Deimos48/Braille_Public/Скриншоты 3D моделей/Основание (2).png

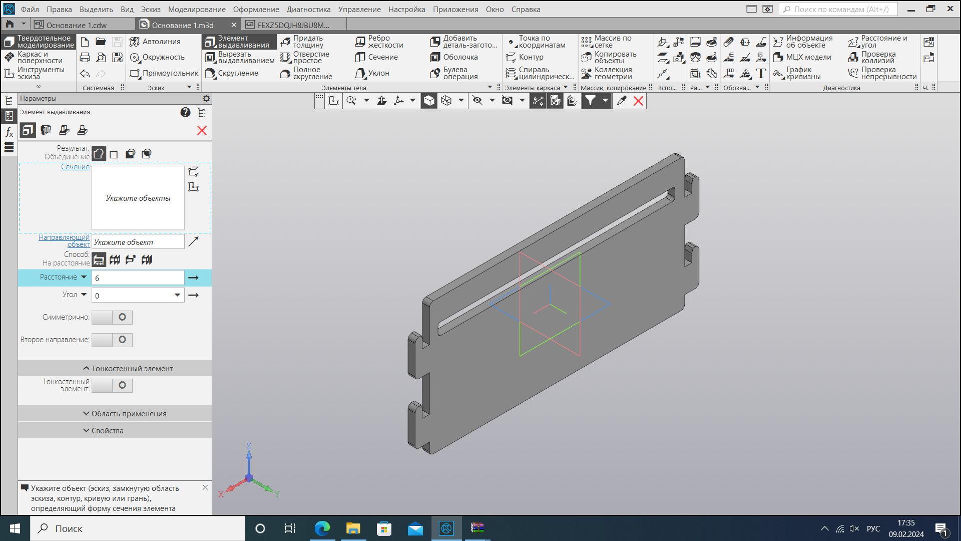
Скриншоты 3D моделей/Основание (2).png
