Deimos48/Braille_Public/Документация для предпрофиля.pdf

Московская предпрофессиональная олимпиада (https://predprof.olimpiada.ru/)

Инженерно-конструкторское направление. Инженерно-конструкторский профиль

ДЕПАРТАМЕНТ ОБРАЗОВАНИЯ И НАУКИ ГОРОДА МОСКВЫ

Государственное бюджетное общеобразовательное учреждение

города Москвы «Школа № 1103 имени Героя Российской Федерации

А.В. Соломатина»

Продуктовый сектор. Профиль «Инженерия»

Пояснительная записка к кейсу №1

Принтер Брайля с голосовым управлением

Выполнили:

ученики 11Б класса ГБОУ Школы № 1103

Ларкин Григорий Максимович,

Григорьев Андрей Андреевич,

Приоров Артемий Сергеевич,

Рахманин Максим Олегович,

Донцов Илья Игоревич

Руководитель:

Сокур М.Е., учитель информатики

Москва, 2024

Оглавление

4. Описание используемых аппаратных и программных узлов, модулей,
5. Функциональное описание разработанного решение в виде UML-
9. Алгоритм работы разработанного программного обеспечения в виде
12. Видеоролик, демонстрирующий функционирование разработанного

### 1. Цель и задачи работы

1.1. | Цель работы – | Разработать и изготовить принтер Брайля (далее

программно-аппаратный комплекс или ПАК) с расширенным функционалом,

в том числе с голосовым управлением, для быстрого создания печатных

заметок для людей с ограничениями по зрению.

1.2. Задачи работы:

− Разработать и создать корпус ПАК;

− Разработать и создать кинематическую схему печати символов;

− Разработать и создать электротехническую систему устройства;

− Выбор микроконтроллера для разработанной системы;

− Разработать систему голосового управления для распознавания

| текста и команд;

− Разработать алгоритмы и ПО для разработанной архитектуры ПАК.

### 2. Описание команды

Членами нашей команды являются Григорьев Андрей, Донцов Илья,

Ларкин Григорий, Приоров Артемий, Рахманин Максим. Распределение ролей

представлено в Таблица 1.

Таблица 1. Распределение ролей в команде

Фамилия, имя члена команды | Задача ученика в команде
Григорьев Андрей | Сборка ПАК, исправление возникших проблем
Донцов Илья | Создание программного кода
Ларкин Григорий | Сборка ПАК, поиск требуемых компонентов и материалов
Приоров Артемий | Создание 3D-моделей ПАК, чертежей, кинематических схем
Рахманин Максим | Разработка документации, создание UML-схем

### 3. Описание функций разработанного решения

3.1. Управление принтера производится с помощью голосовых команд,

произносимых пользователем. Например, команда «Абзац» делает

перенос на новую строку.

3.2. Когда пользователь произносит команду «Запись», встроенный

микрофон начинает распознавать и записывать слова в течении 5

секунд. При необходимости максимальное время записи можно

программно изменить.

3.3. Записанная на микрофон речь передаётся микрокомпьютером

Raspberry Pi 3 в сервис Yandex Cloud, где происходит её

распознавание. | Текстовое | содержимое | сохраняется | на

микрокомпьютере.

3.4. Как только речь была записана, Raspberry Pi 3 передаёт её на

микроконтроллер Arduino. Там речь переводится в текст Брайля и

подаётся на печать.

3.5. Печать происходит построчно. Печатная головка двигается по

горизонтали с помощью шагового мотора. Прокрутка бумаги по

вертикали реализована вторым шаговым мотором и системой

прижимных роликов.

4. Описание используемых аппаратных и программных узлов,

модулей, фреймворков и других инструментов

Список основных компонентов, используемых для создания данного

проекта, представлен в Таблица 2.

Таблица 2. Используемые компоненты и ПО

Название компонента и его назначение в проекте | Внешний вид

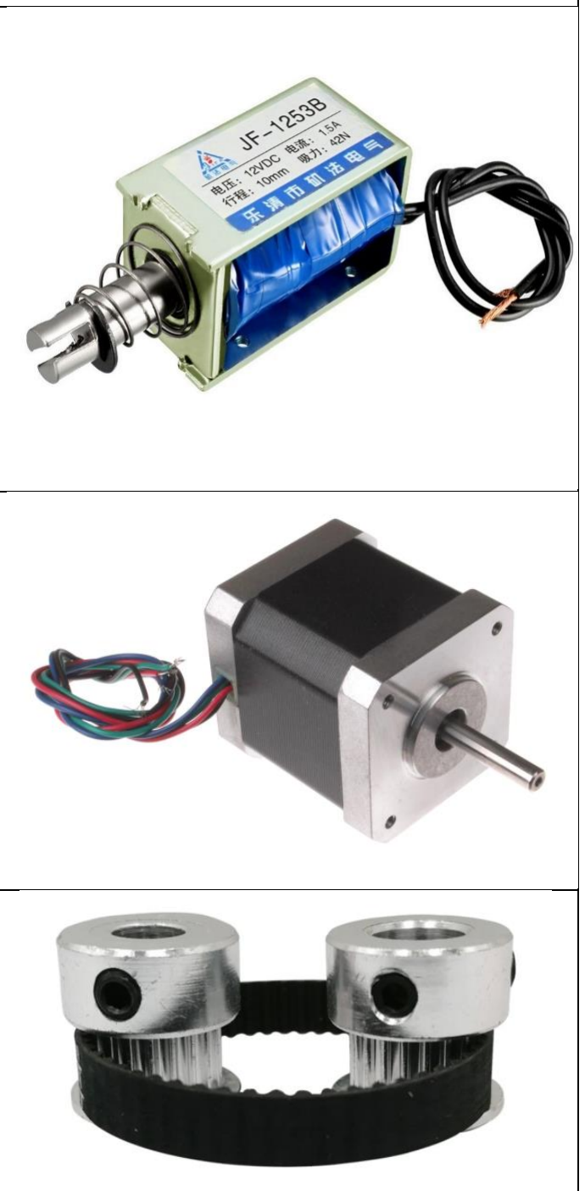
[picture p3: figure]

Соленоид JF-1253B В данном проекте он используется для печати на бумаге рельефно-точечным шрифтом Луи Брайля.

Шаговый мотор Nema17 Предназначены для перемещения печатной головки по горизонтальной плоскости, листа бумаги по вертикальной плоскости

Шкив GT2-20 С помощью ременной передачи вращение с шаговых двигателей передаётся на ремень, который приводит в движение печата ющую головку принтера

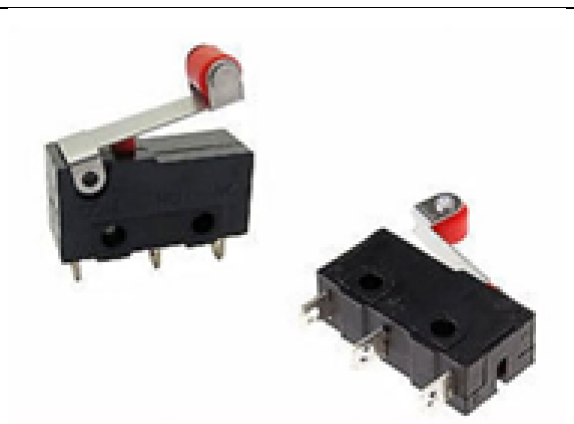
[picture p4: figure]

Концевой переключатель Подаёт на плату Arduino сигнал, когда печатная головка дошла до крайнего положения листа. После получения этого сигнала продвигается бумажный лист, чтобы продолжить печать на новой строке.

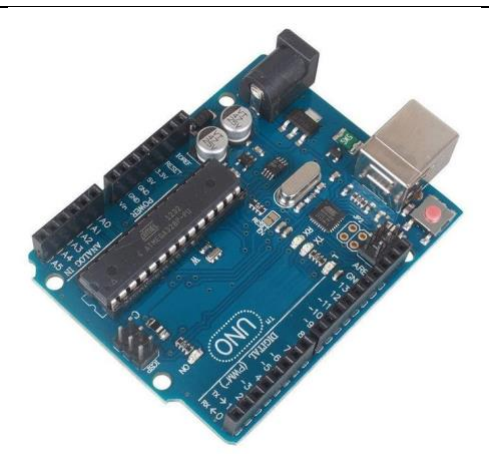
[picture p5: figure]

Arduino Uno Микроконтроллер, отвечающий за управление шаговыми моторами и печатью. Весь программный код писался в интегрированной среде разработки Arduino IDE, использующий C-подобный язык программирования.

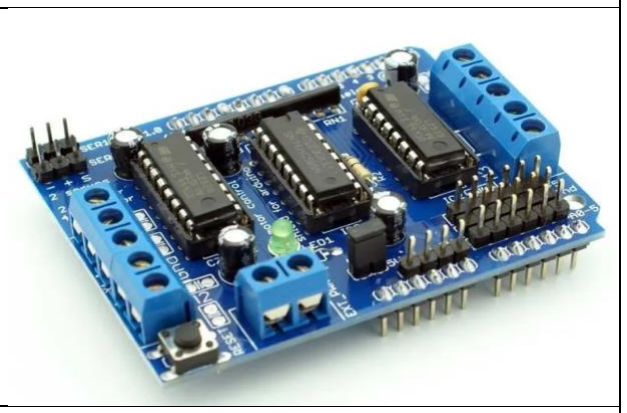
[picture p6: figure]

Motor Shield Плата расширения, предназначенная для управления скоростью и направлению вращения шаговых моторов постоянного тока.

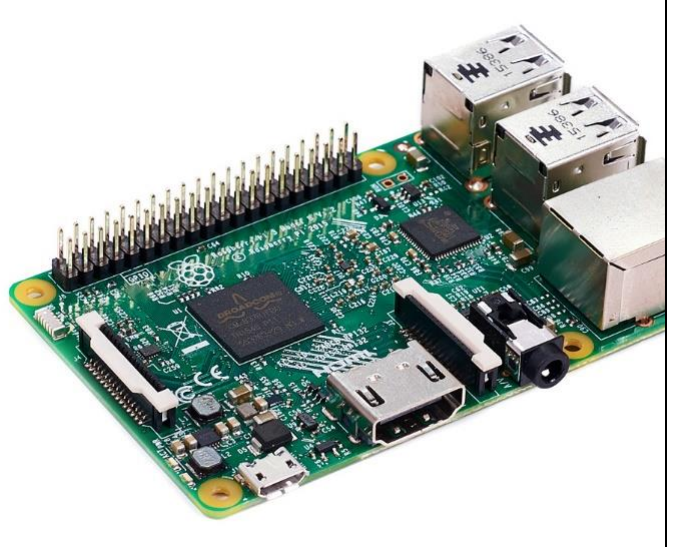
[picture p7: figure]

Raspberry Pi 3 Микрокомпьютер, на котором, за счёт облачных сервисов, реализовано распознавание речи. В данном проекте используются следующие модули: time, requests, RPi.GPIO, soundfile, pyaudio, wave, serial

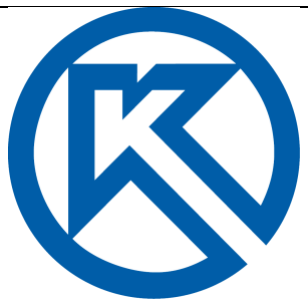
[picture p8: figure]

САПР «Компас-3D» Средство автоматического проектирования, в котором создавались 3D модели деталей, чертежи, кинематические схемы

Arduino IDE Интегрированная среда программирования. Предназначена для разработки и загрузки программного кода на Arduino-совместимые платы. В данном проекте используются следующие библиотеки: AFMotor, TMRpcm

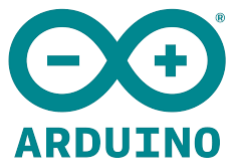
[picture p9: figure]

### 5. Функциональное описание разработанного решение в виде

UML-диаграмм

### 5.1. Диаграмма вариантов пользовательского взаимодействия с

системой

Произнеся команду «Запись», пользователь может говорить в микрофон

текст для печати, а также команды для принтера, управляя его работой. Также

пользователь может класть и доставать бумагу для печати. В необходимый

момент, пользователь может нажать на кнопку Reset, тем самым остановить

печать.

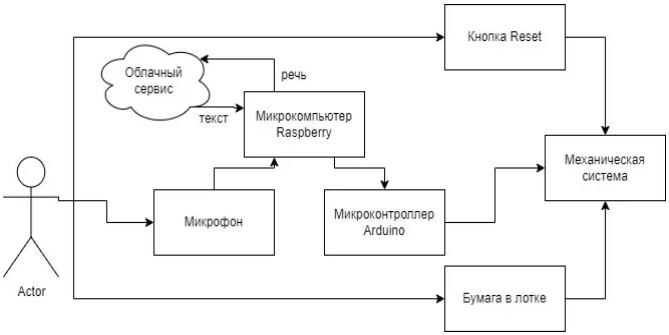
[picture p10: figure]

Рисунок 1. Диаграмма вариантов пользовательского взаимодействия с системой

### 5.2. Диаграмма автомата

У принтера есть 2 основных состояния: выключенное и включённое. Во

втором состоянии он выполняет свои основные функции: после включения он

ждёт голосовой команды «Запись» для начала работы, после чего записывает

речь пользователя. Записанный аудиофайл сохраняется на микрокомпьютер

Raspberry Pi 3, который отправляет его на облачный сервис Yandex Cloud, где

происходит распознавание речи. Получившийся в результате работы

облачного сервиса текстовый файл с распознанной речью отправляется

обратно на Raspberry Pi 3. Далее текст отправляется на микроконтроллер

Arduino, где преобразуется в текст Брайля и отправляется на печать.

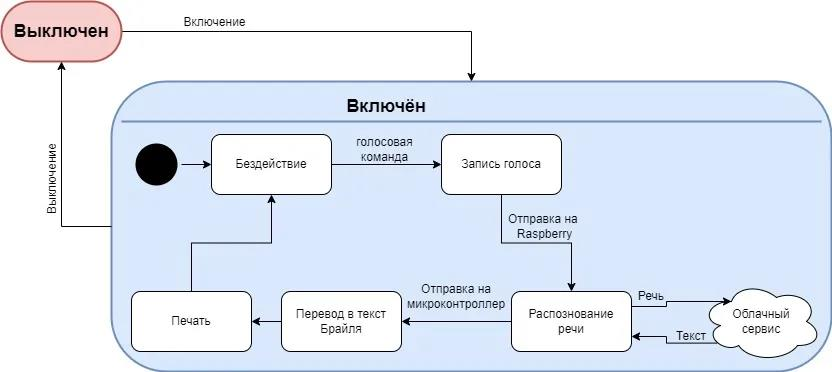
[picture p11: figure]

Рисунок 2. Диаграмма автомата

### 5.3. Диаграмма последовательности

После включения система ждёт, когда пользователь произнесёт команду

«Запись» для начала записи. После записи полученная речь отправляется

микрокомпьютером Raspberry Pi 3 для распознавания. С помощью облачного

сервиса Yandex Cloud реализовано распознавание речи. После обработки

микрокомпьютер передаёт полученный текст на микроконтроллер, где

происходит перевод в текст Брайля и совершается отправка на печать. При

обнаружении неполадки или иных непредвиденных ситуациях, пользователь

может нажать на кнопку Reset, чтобы совершить аварийную остановку.

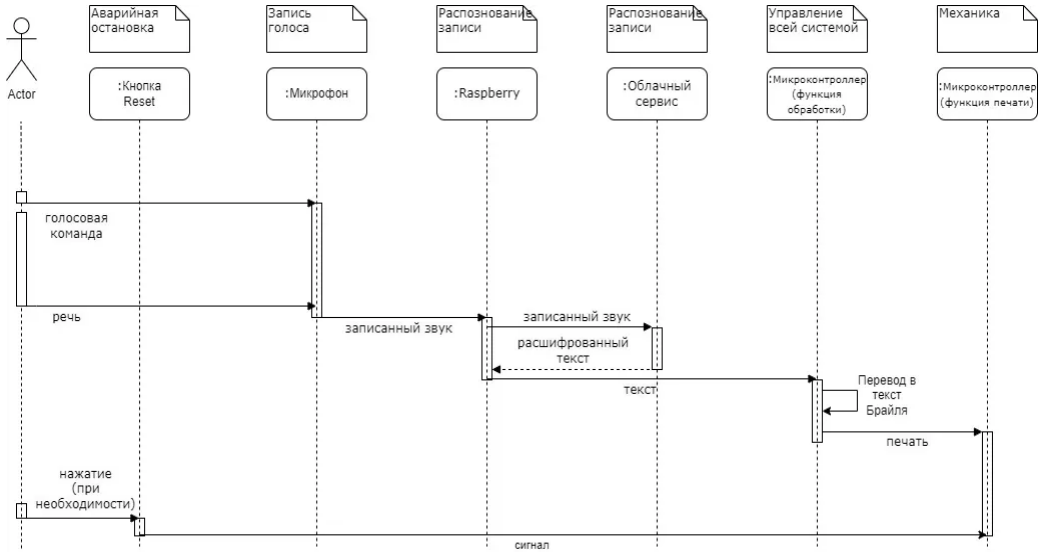
[picture p12: figure]

Рисунок 3. Диаграмма последовательности

### 5.4. Диаграмма компонентов

В нашем проекте используется один микроконтроллер, к которому

подключены все составляющие механизма печати. Также мы используем

микрокомпьютер Raspberry Pi 3 с подключенным к нему микрофоном для

распознавания речи. Специальная команда начала записи активирует

микрофон, а кнопка Reset напрямую взаимодействует с механизмом печати и

может остановить процесс при необходимости. Полученная при записи речь

сохраняется на микрокомпьютер Raspberry Pi 3, который отправляет её на

облачный сервис Yandex Cloud, где происходит распознавание речи.

Полученный таким образом текстовый файл обратно возвращается на

микрокомпьютер, который передаёт его микроконтроллер Arduino Uno, где

преобразуется по шрифту Брайля и отправляется на печать.

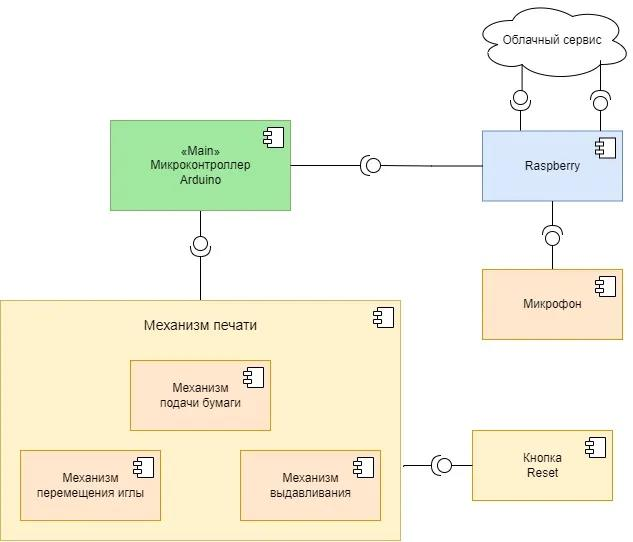
[picture p13: figure]

Рисунок 4. Диаграмма компонентов

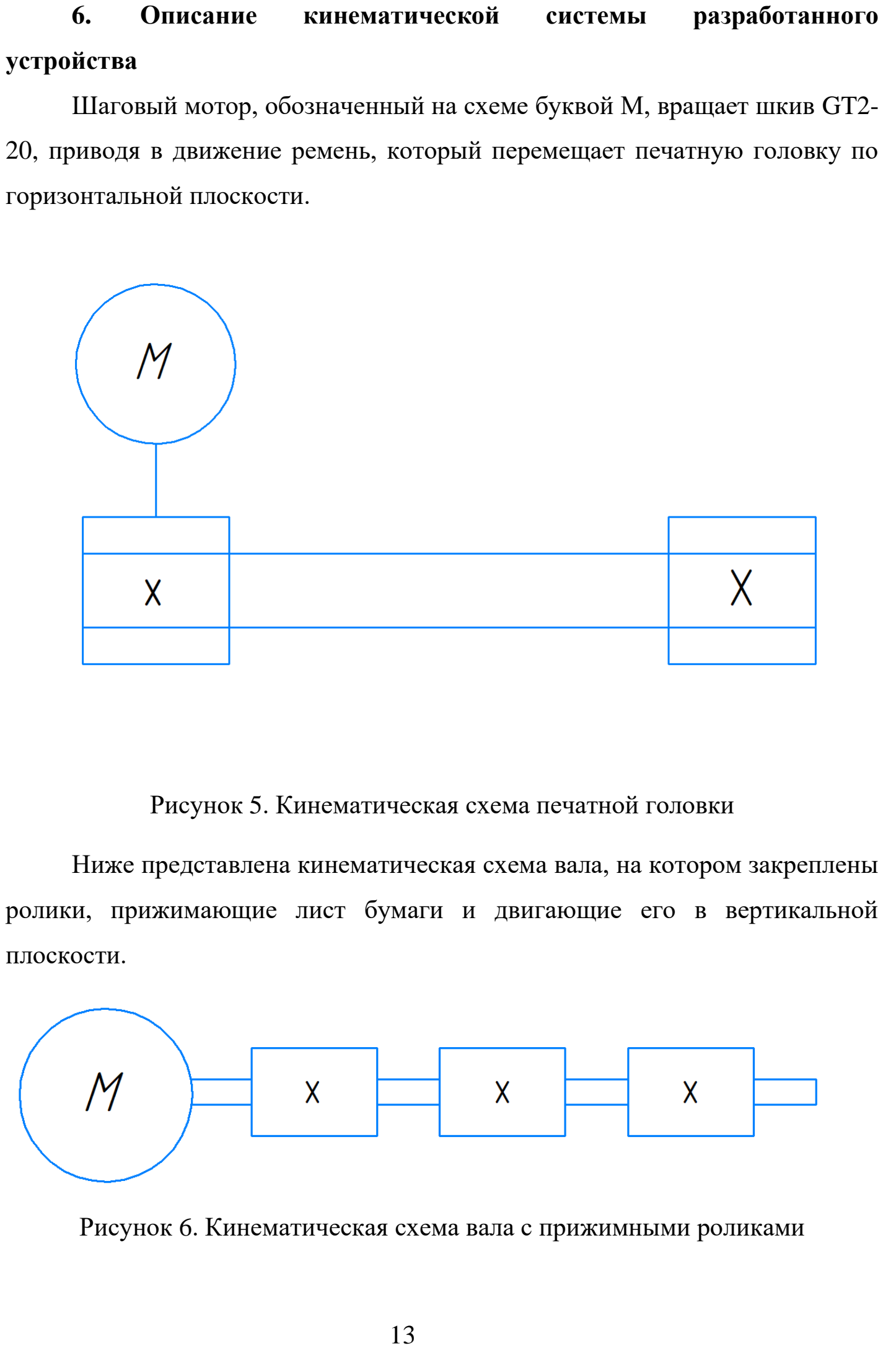
[picture p14: page 13]

6. | Описание | кинематической | системы | разработанного

устройства

Шаговый мотор, обозначенный на схеме буквой М, вращает шкив GT2-

20, приводя в движение ремень, который перемещает печатную головку по

горизонтальной плоскости.

Рисунок 5. Кинематическая схема печатной головки

Ниже представлена кинематическая схема вала, на котором закреплены

ролики, прижимающие лист бумаги и двигающие его в вертикальной

плоскости.

Рисунок 6. Кинематическая схема вала с прижимными роликами

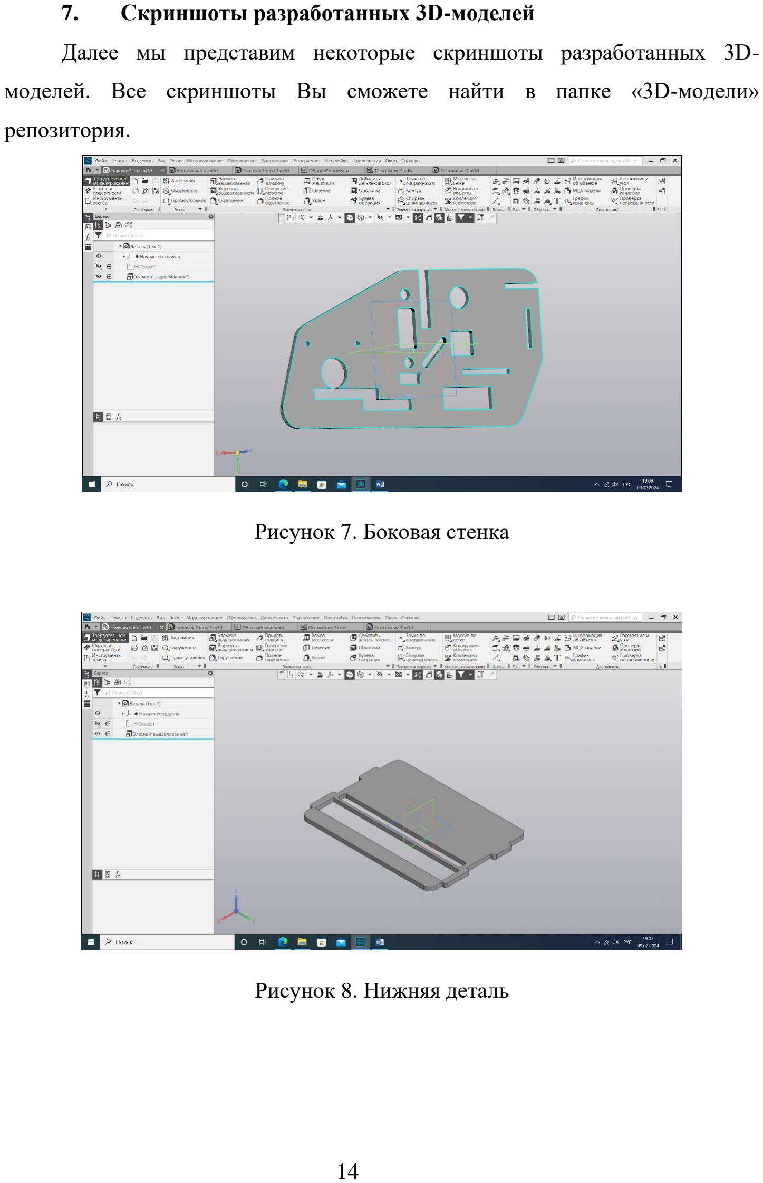
[picture p15: page 14]

### 7. Скриншоты разработанных 3D-моделей

Далее мы представим некоторые скриншоты разработанных 3D-

моделей. Все скриншоты Вы сможете найти в папке «3D-модели»

репозитория.

Рисунок 7. Боковая стенка

Рисунок 8. Нижняя деталь

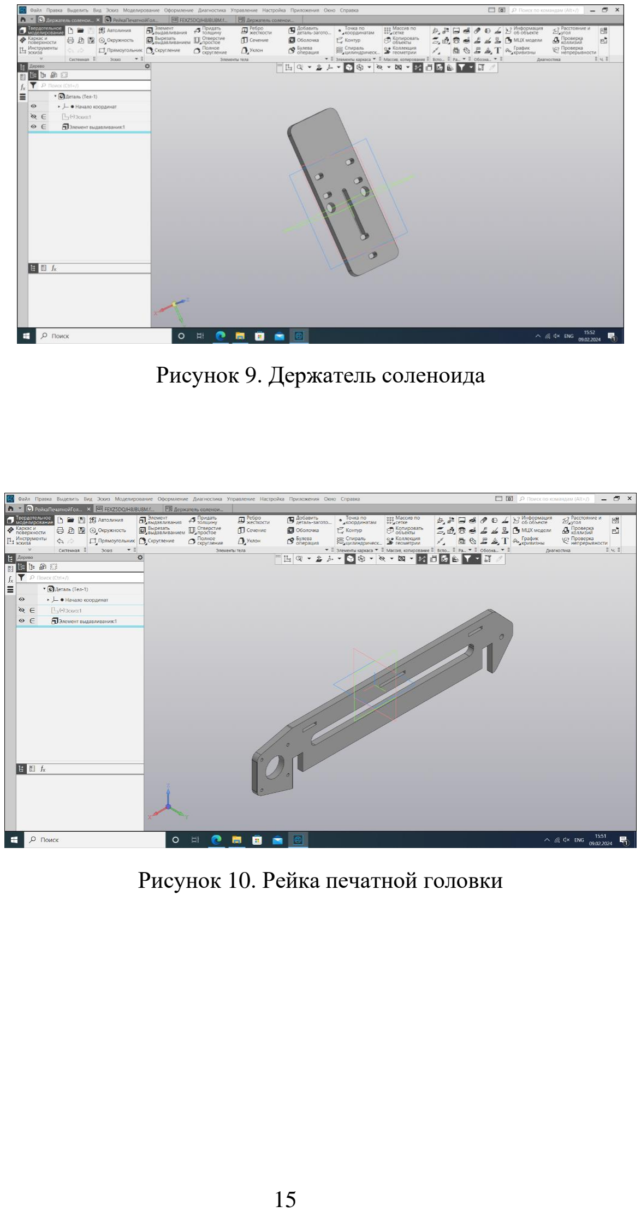
[picture p16: page 15]

Рисунок 9. Держатель соленоида

Рисунок 10. Рейка печатной головки

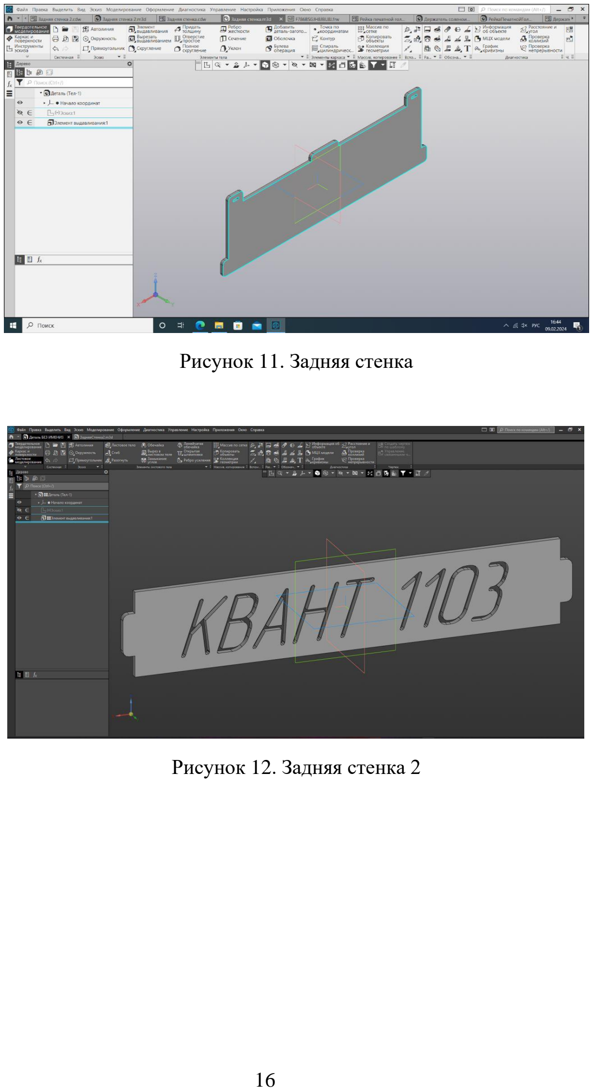
[picture p17: page 16]

Рисунок 11. Задняя стенка

Рисунок 12. Задняя стенка 2

8. | Описание | электротехнической | схемы | разработанного

устройств

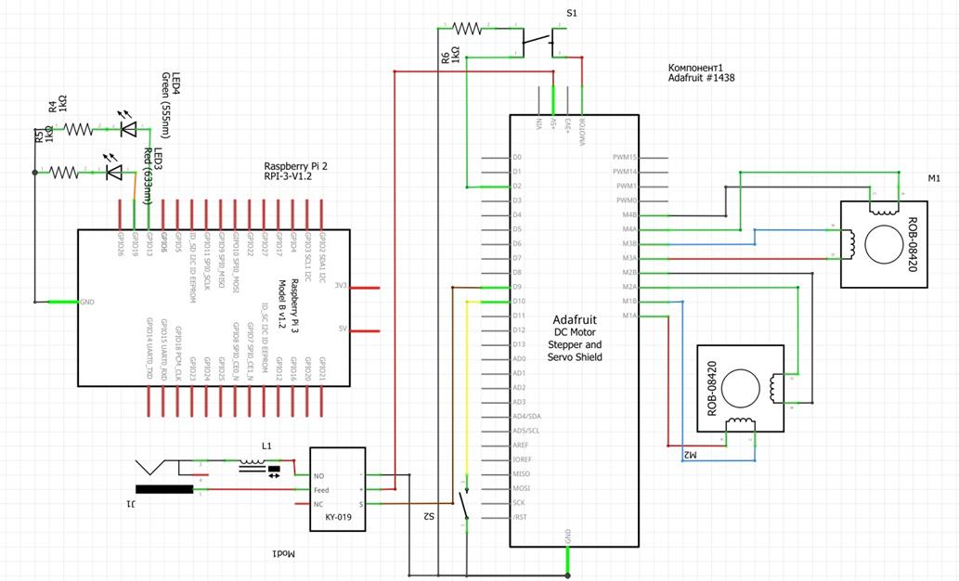
[picture p18: figure]

Рисунок 13. Принципиальная электрическая схема

К микроконтроллеру Arduino Uno подключена дополнительная плата

(Motor Shield) для управления шаговыми двигателями М1 и М2. К плате

подключен дополнительный источник питания +5В для питания двигателей.

Управление соленоидом осуществляется через порт D9, который управляет

промежуточным реле К1. Напряжение питания соленоида 12В. Концевой

выключатель подключен к порту D10. Кнопка аварийного останова

подключена к порту D2.

Связь | с | микрокомпьютером | Raspberry | осуществляется | по

последовательному интерфейсу. Используется внутренний преобразователь

USB-RS232, поэтому не требуется согласование уровней напряжения Arduino

(5 В) и Raspberry (3,3 В). На микрокомпьютере Raspberry для индикации

начала и завершения распознавания используются два светодиода. Для

ограничения тока светодиодов используются токоограничивающие резисторы

R4, R5 по 1 кОм.

### 9. Алгоритм работы разработанного программного обеспечения

в виде блок-схем

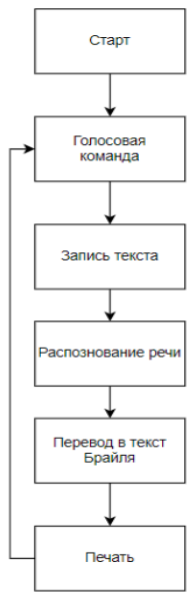
[picture p19: figure]

Рисунок 14. Общий алгоритм ПО

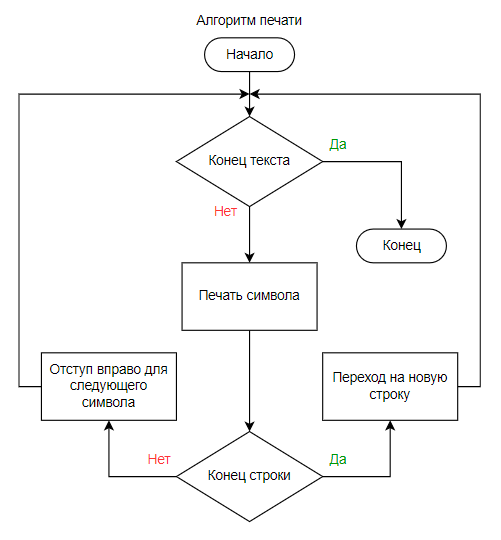
[picture p20: figure]

Рисунок 15. Алгоритм печати

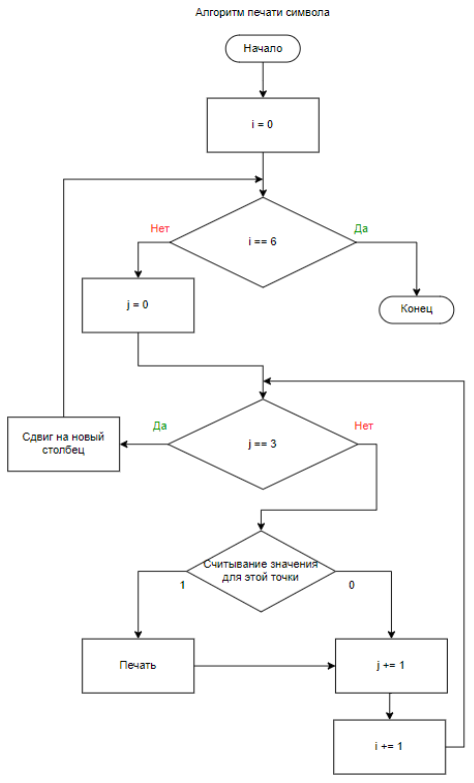
[picture p21: figure]

Рисунок 16. Алгоритм печати символа

10. Код разработанного программного обеспечения.

Код для работы нашего проекта Вы можете найти по этой ссылке:

- https://github.com/Deimos48/Braille_Public/tree/main/%D0%9F%D1

%80%D0%BE%D0%B3%D1%80%D0%B0%D0%BC%D0%BC%D

0%BD%D1%8B%D0%B9_%D0%BA%D0%BE%D0%B4/Python (https://github.com/Deimos48/Braille_Public/tree/main/%D0%9F%D1%80%D0%BE%D0%B3%D1%80%D0%B0%D0%BC%D0%BC%D0%BD%D1%8B%D0%B9_%D0%BA%D0%BE%D0%B4/Python)

- https://github.com/Deimos48/Braille_Public/tree/main/%D0%9F%D1

%80%D0%BE%D0%B3%D1%80%D0%B0%D0%BC%D0%BC%D

0%BD%D1%8B%D0%B9_%D0%BA%D0%BE%D0%B4/Arduino (https://github.com/Deimos48/Braille_Public/tree/main/%D0%9F%D1%80%D0%BE%D0%B3%D1%80%D0%B0%D0%BC%D0%BC%D0%BD%D1%8B%D0%B9_%D0%BA%D0%BE%D0%B4/Arduino)

### 11. Фотографии разработанного устройства и его составных

частей.

Фотографии разработанного устройства Вы можете найти по этой

ссылке:

- https://github.com/Deimos48/Braille_Public/tree/main/Фотографии_

разработанного_устройства (https://github.com/Deimos48/Braille_Public/tree/main/%D0%A4%D0%BE%D1%82%D0%BE%D0%B3%D1%80%D0%B0%D1%84%D0%B8%D0%B8_%D1%80%D0%B0%D0%B7%D1%80%D0%B0%D0%B1%D0%BE%D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)

12. | Видеоролик, | демонстрирующий | функционирование

разработанного устройства

Видеоролик Вы можете найти, по ссылке:

- https://github.com/Deimos48/Braille_Public/tree/main/Видеоролик

### 13. Заключение

В результате работы был создан принтер Брайля с голосовым

управлением, который способен:

1. Выполнять печать на бумаге формата A4;
2. По специальной голосовой команде считывать речь пользователя;
3. Печатать один символ со скоростью менее 5 секунд с учётом времени

на перенос строки;

4. Производить печать произнесённой речи на бумагу рельефно-

точечным шрифтом Брайля;

5. Обеспечивать печать символов кириллицей;
6. Использовать для управления русский язык;
7. Не оставлять сквозных отверстий, разрывов и других повреждений

листа;

8. Распознавать текст менее чем за 15 секунд;
9. Переносить печать на новую строчку с помощью специальной

голосовой команды;

10. Работать без подключения к персональному компьютеру;
11. Выполнить аварийную остановку после нажатия на специальную

кнопку.

Конструкция ПАК предусматривает лёгкое взятие листа по завершению

печати.

Готовый результат печати представлен ни рисунках ниже.

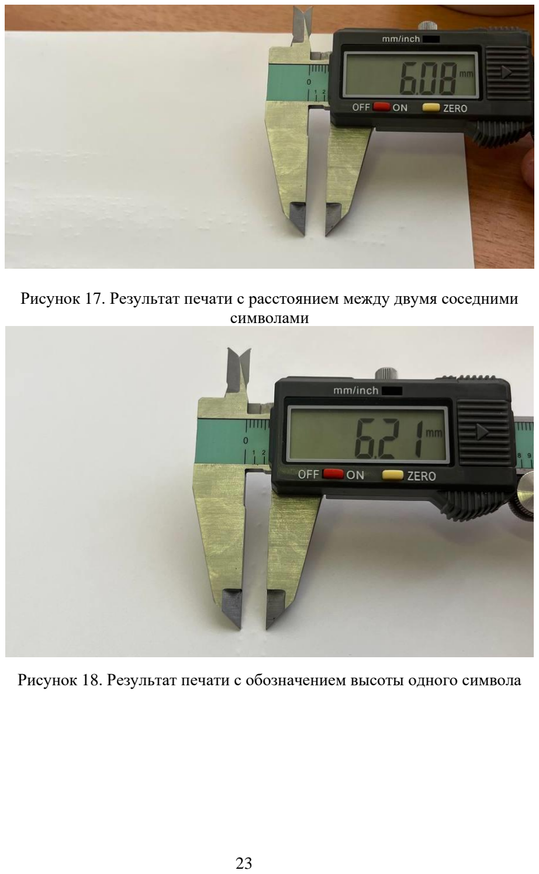
[picture p22: page 23]

Рисунок 17. Результат печати с расстоянием между двумя соседними символами

Рисунок 18. Результат печати с обозначением высоты одного символа

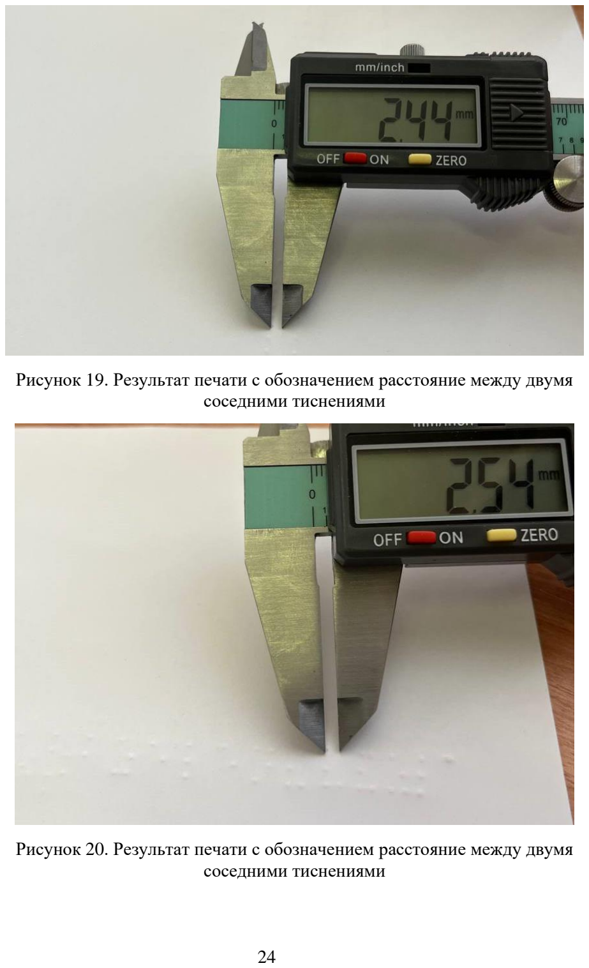
[picture p23: page 24]

Рисунок 19. Результат печати с обозначением расстояние между двумя соседними тиснениями

Рисунок 20. Результат печати с обозначением расстояние между двумя соседними тиснениями

### 14. Список литературных источников

1. Рельефно-точечная система обозначений Л. Брайля: учебное пособие /

сост. Н.П. Шведова, В.З. Денискина. – Москва: МПГУ, 2019. – 76с.

2. ГОСТ Р 56832-2020 Шрифт Брайля. Требования и размеры.
3. Обучающие уроки и проекты для Arduino, ESP, Raspberry Pi 3 Pi. URL:

https://lesson.iarduino.ru.

4. КОМПАС-3D - российская система трехмерного проектирования. URL:

https://kompas.ru/solutions/education/.

5. | Документация | по | GitHub. | URL: | https://docs.github.com/ru/get-

started/quickstart/hello-world.
