Deimos48/Braille_Public/Кинематические схемы/Кинематическая схема 2.png

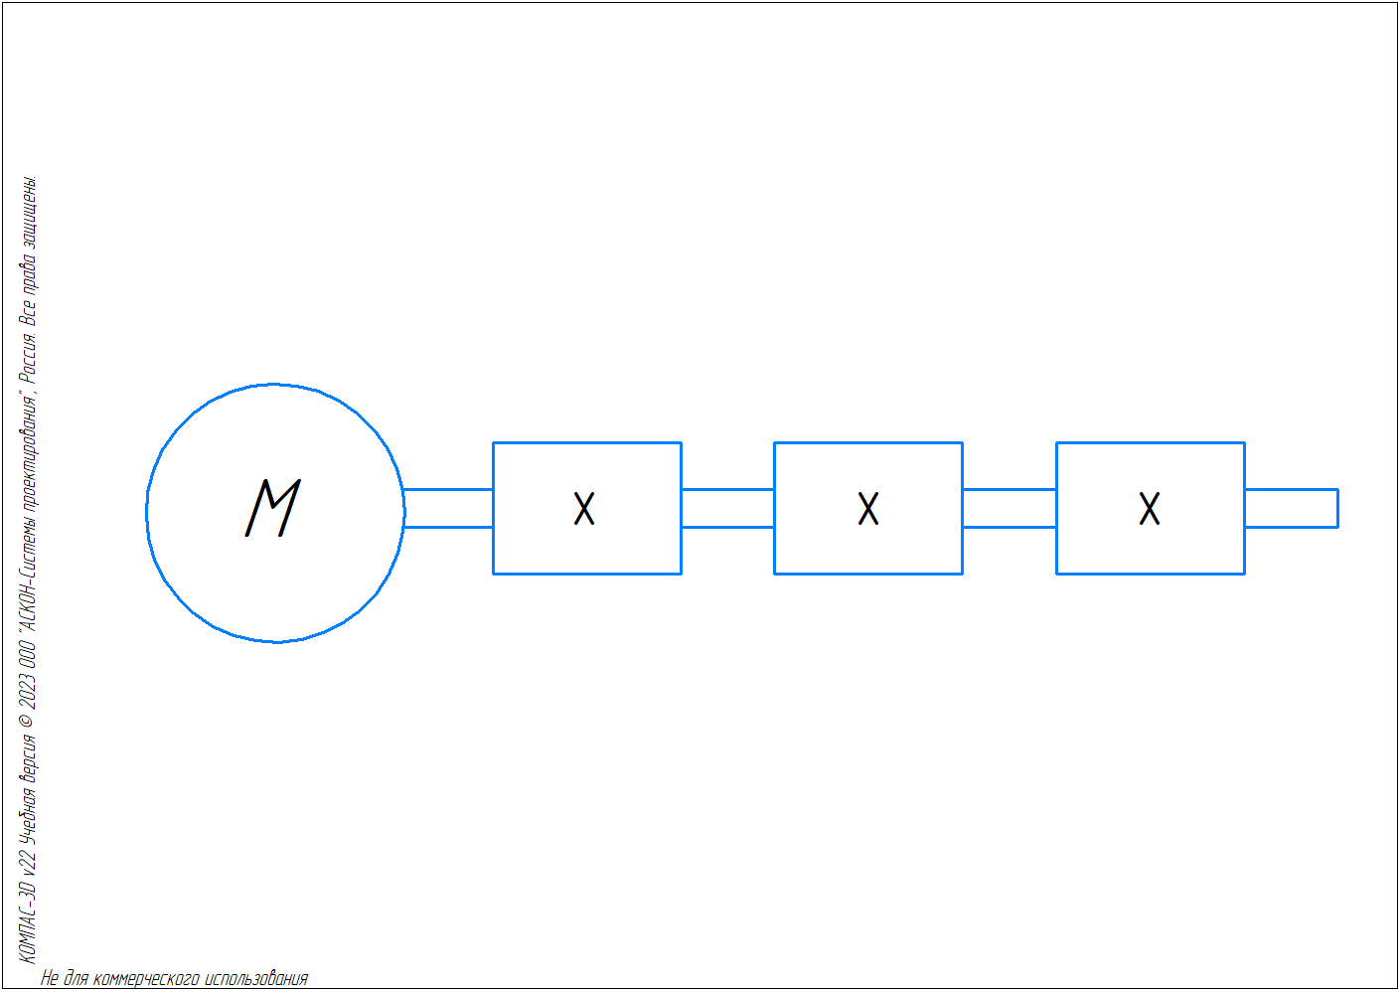
Кинематические схемы/Кинематическая схема 2.png
