Deimos48/Braille_Public/Кинематические схемы/Кинематическая схема.png

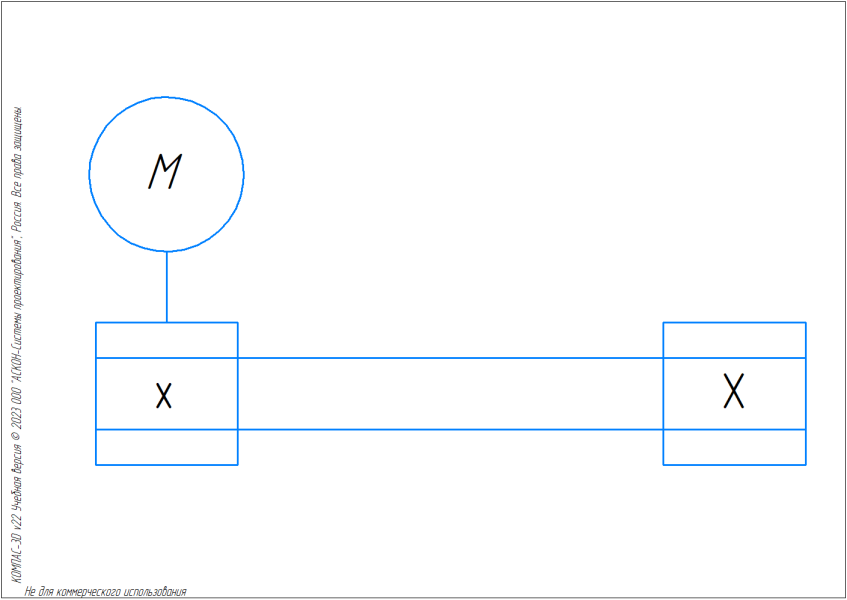
Кинематические схемы/Кинематическая схема.png
