Deimos48/Braille_Public/Скриншоты 3D моделей/Боковая стенка 3.png

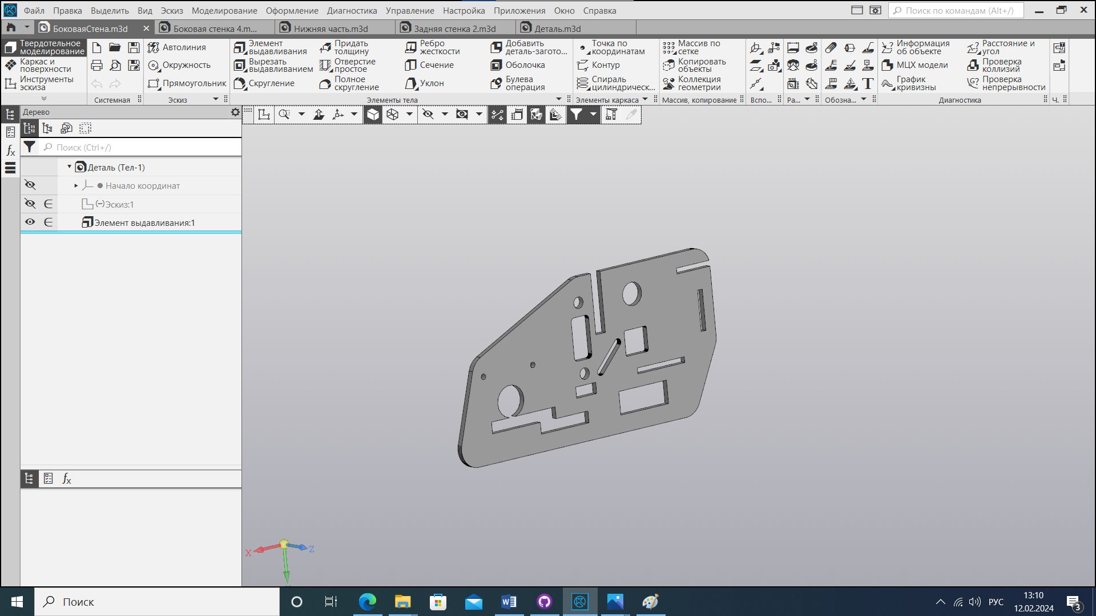
Скриншоты 3D моделей/Боковая стенка 3.png
