Deimos48/Braille_Public/Скриншоты 3D моделей/Боковая стенка_3.png

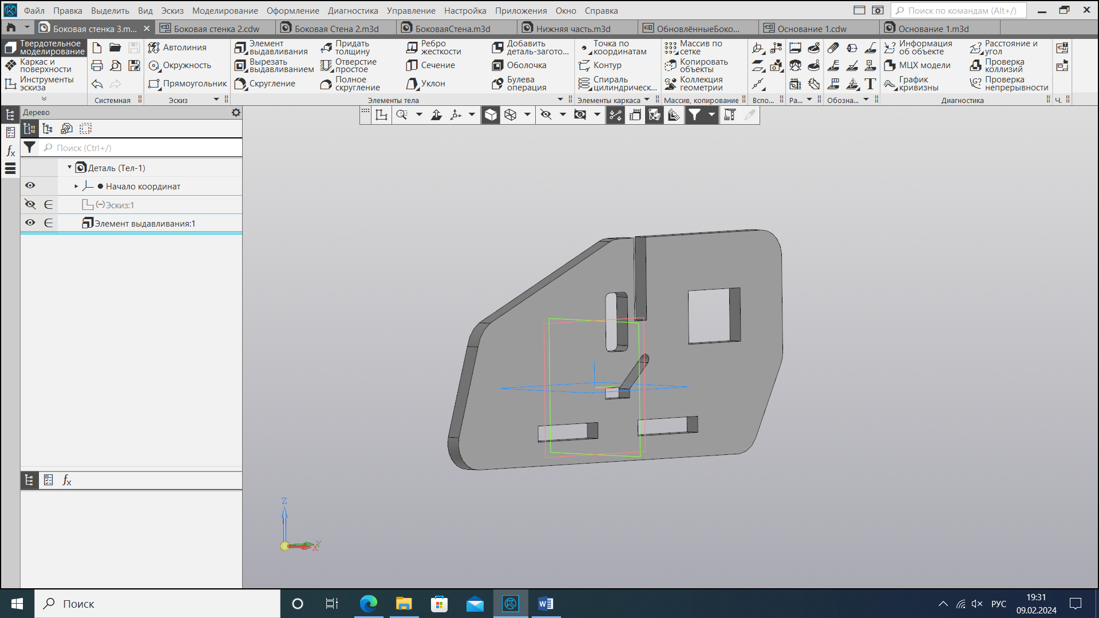
Скриншоты 3D моделей/Боковая стенка_3.png
