Deimos48/Braille_Public/Скриншоты 3D моделей/Держатель соленоида (2).png

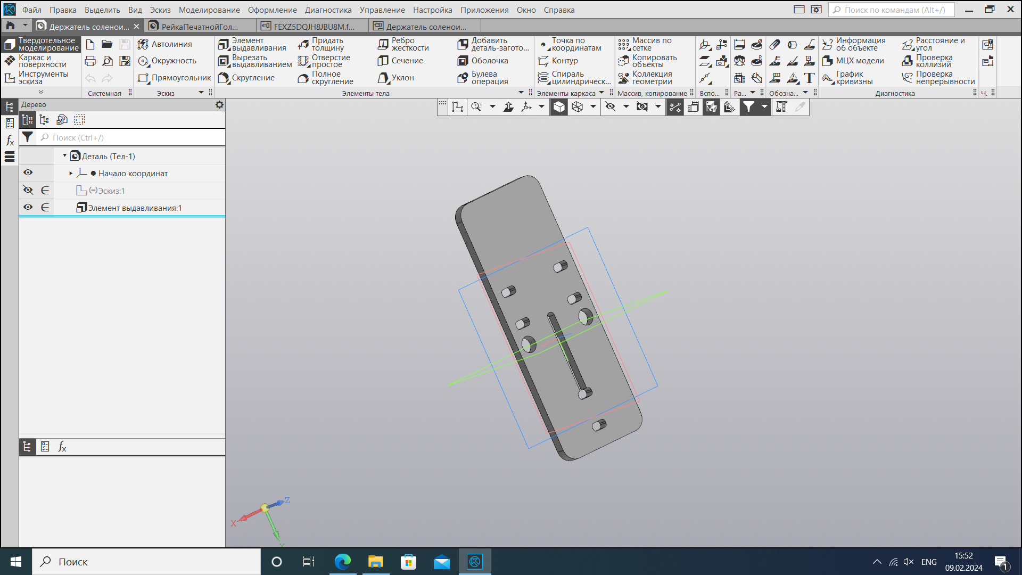
Скриншоты 3D моделей/Держатель соленоида (2).png
