Deimos48/Braille_Public/Скриншоты 3D моделей/Задняя стенка_2.png

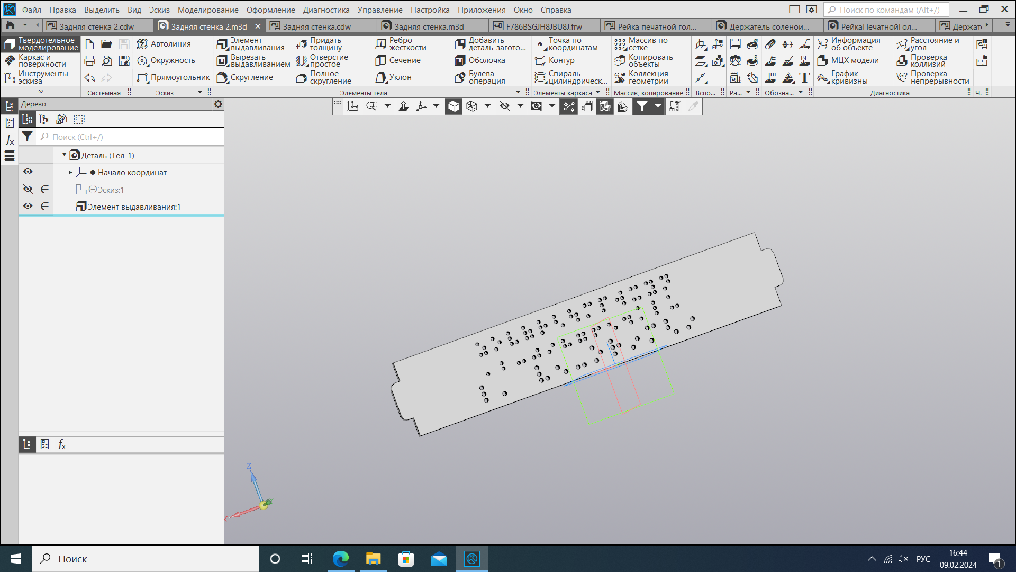
Скриншоты 3D моделей/Задняя стенка_2.png
