Deimos48/Braille_Public/Скриншоты 3D моделей/Основание.png

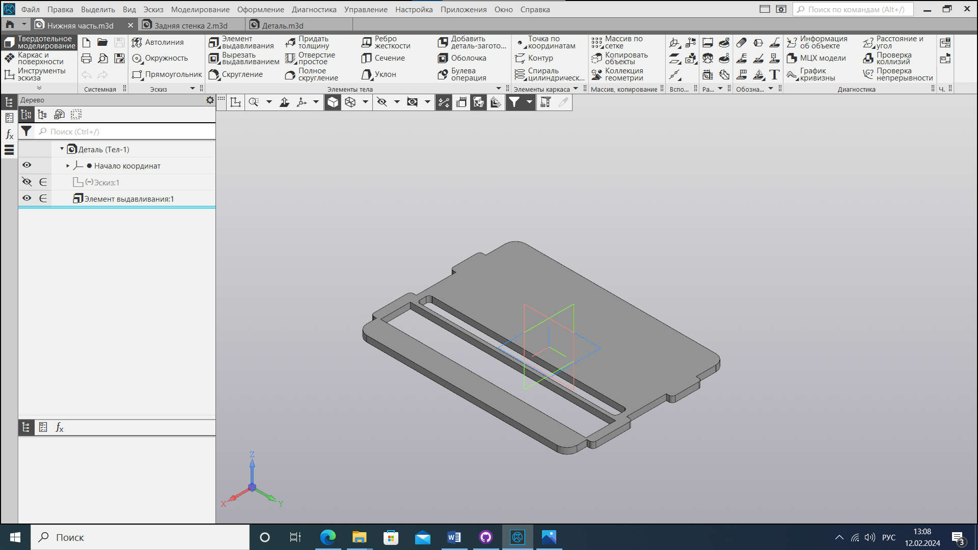
Скриншоты 3D моделей/Основание.png
