Deimos48/Braille_Public/Скриншоты 3D моделей/Рейка печатной головки.png

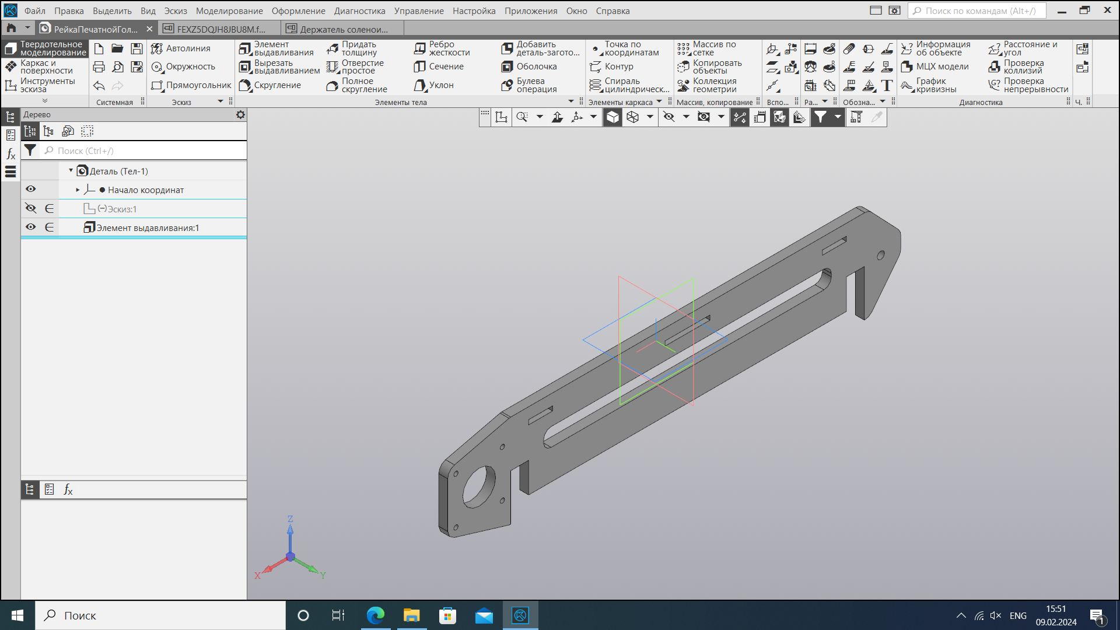
Скриншоты 3D моделей/Рейка печатной головки.png
