Deimos48/Braille_Public/Фотографии_разработанного_устройства_и_результата_работы/Вид_спереди.jpg

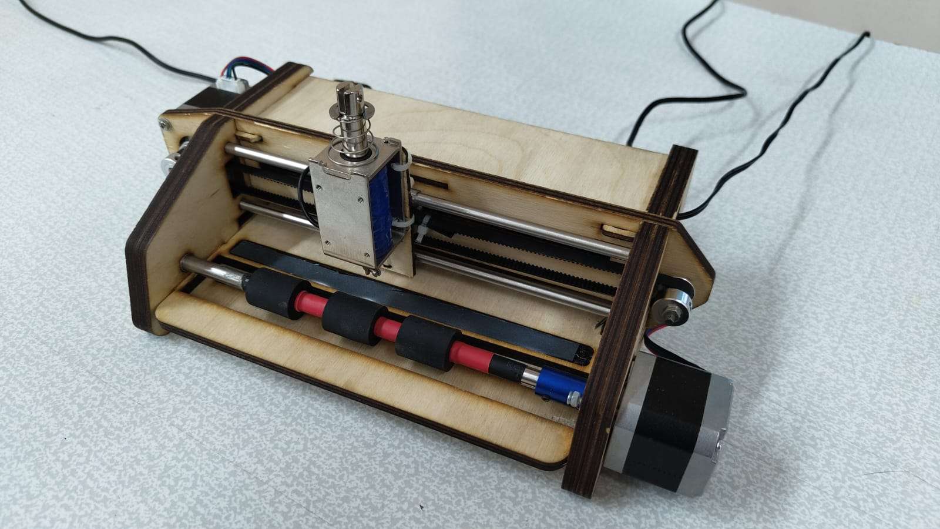
Фотографии_разработанного_устройства_и_результата_работы/Вид_спереди.jpg
