Deimos48/Braille_Public/Фотографии_разработанного_устройства_и_результата_работы/Результат измерения_2.jpeg

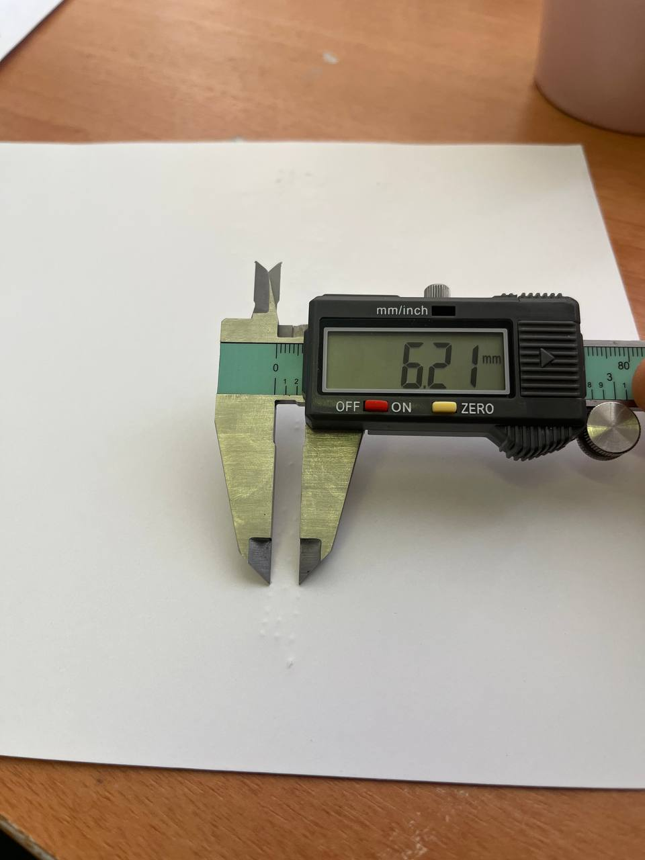
Фотографии_разработанного_устройства_и_результата_работы/Результат измерения_2.jpeg
