Deimos48/Braille_Public/Чертежи/Боковая стенка.png

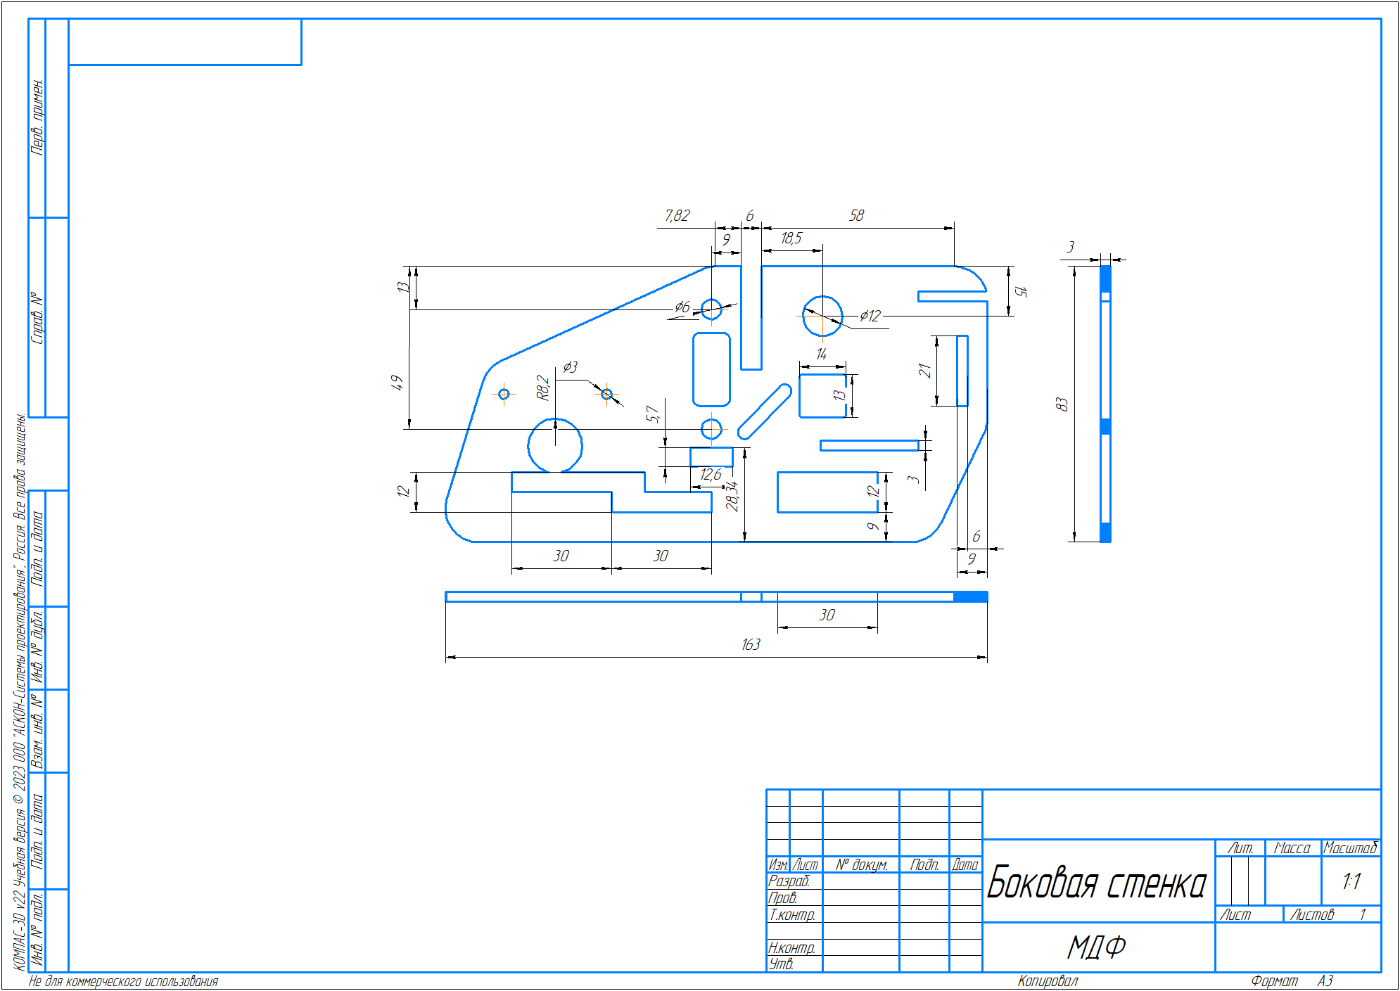
Чертежи/Боковая стенка.png
