Deimos48/Braille_Public/Чертежи/Боковая стенка_2.png

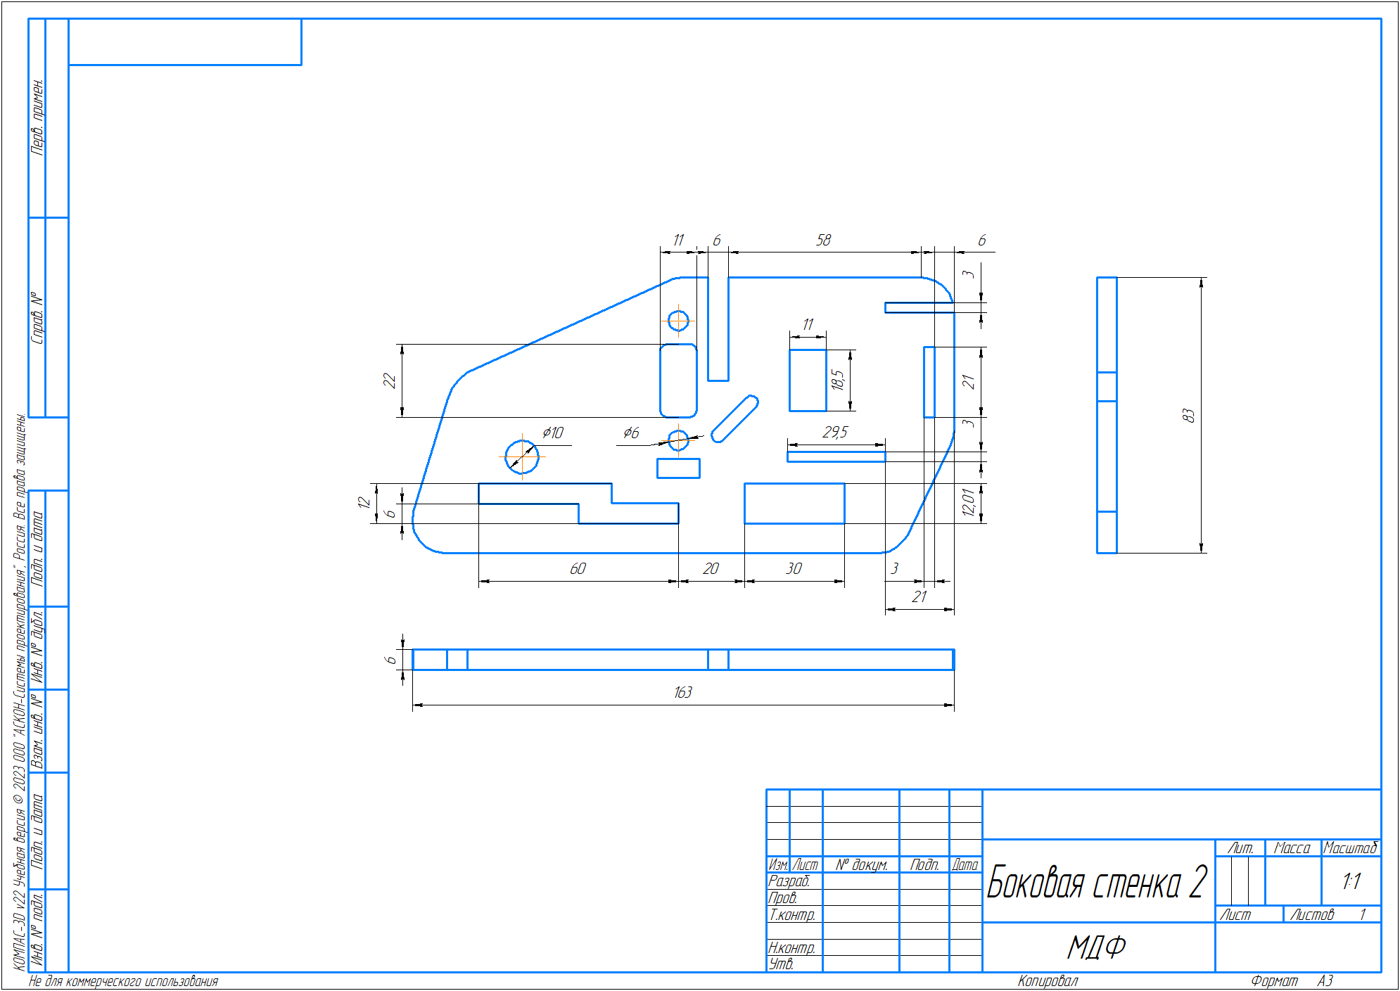
Чертежи/Боковая стенка_2.png
