Deimos48/Braille_Public/Чертежи/Боковая стенка_3.png

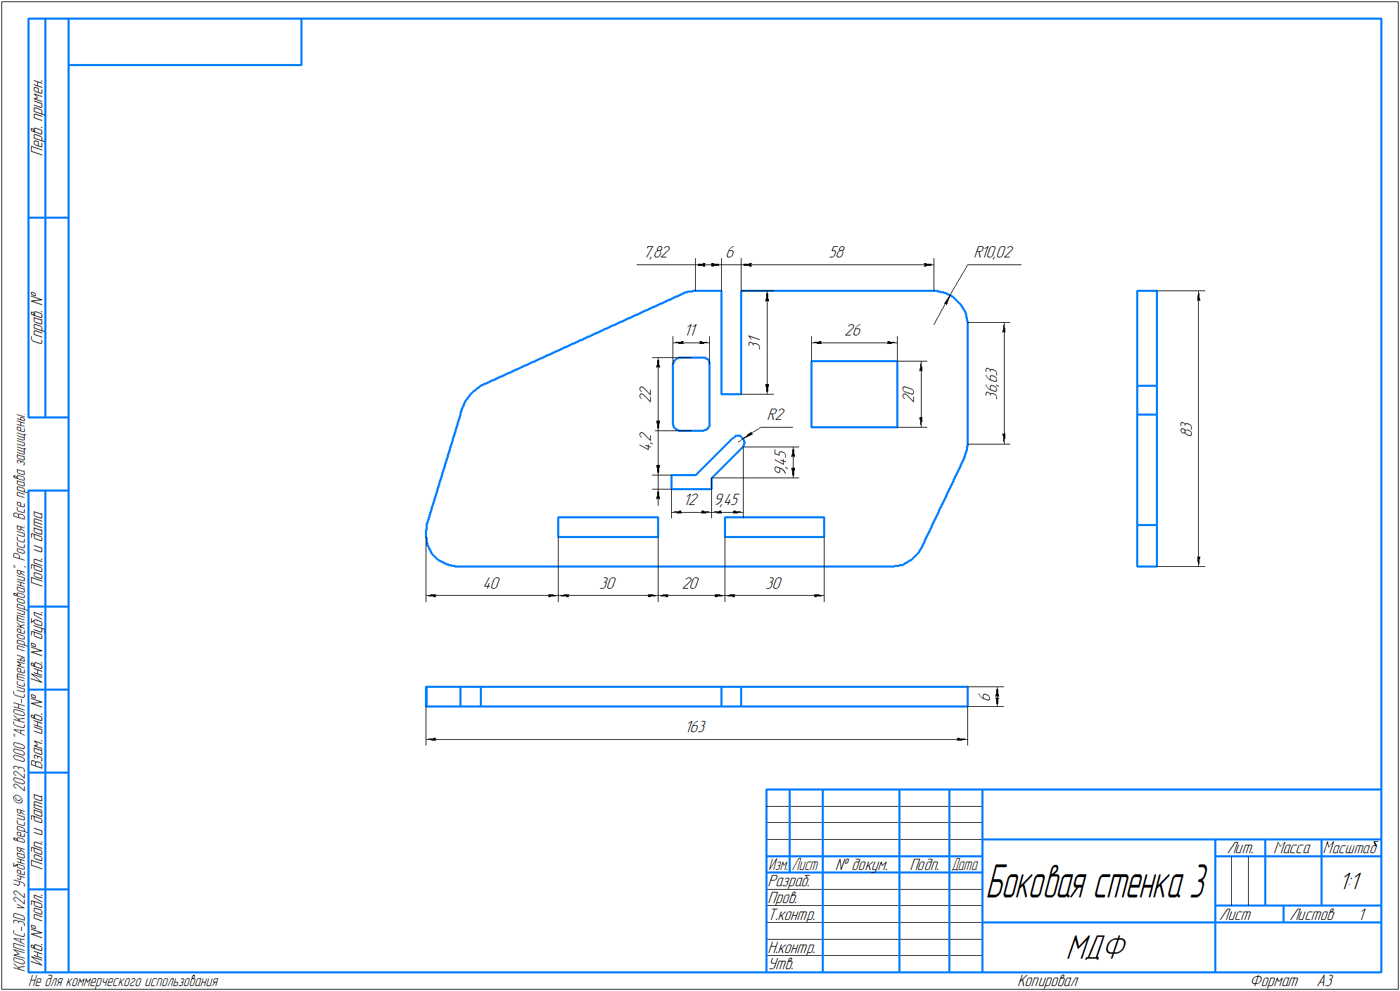
Чертежи/Боковая стенка_3.png
