Deimos48/Braille_Public/Чертежи/Боковая стенка_4.png

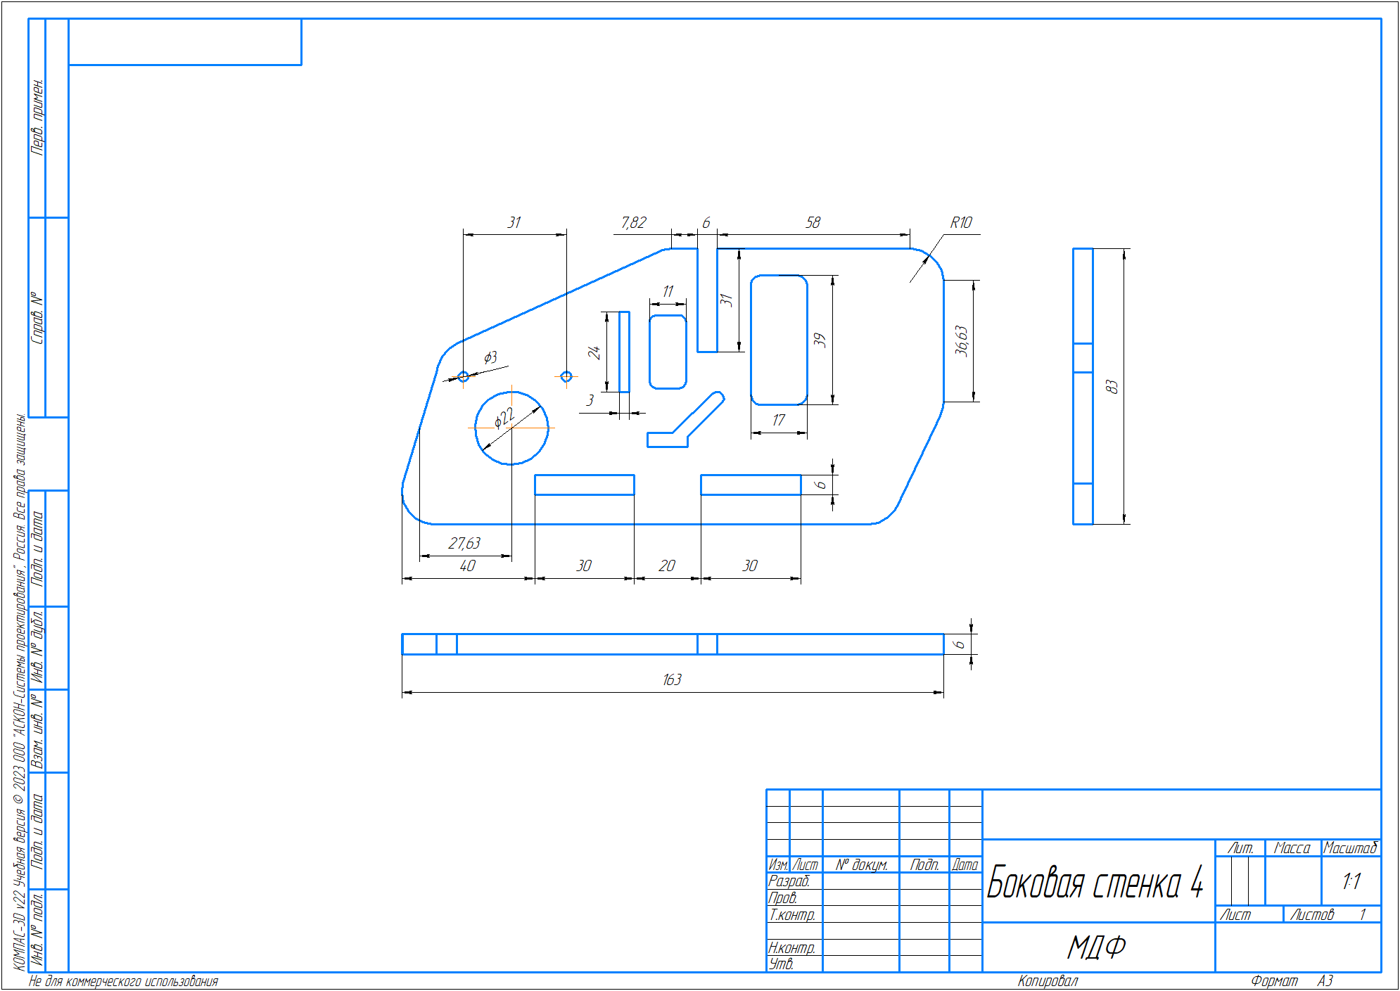
Чертежи/Боковая стенка_4.png
