Deimos48/Braille_Public/Чертежи/Держатель соленоида.png

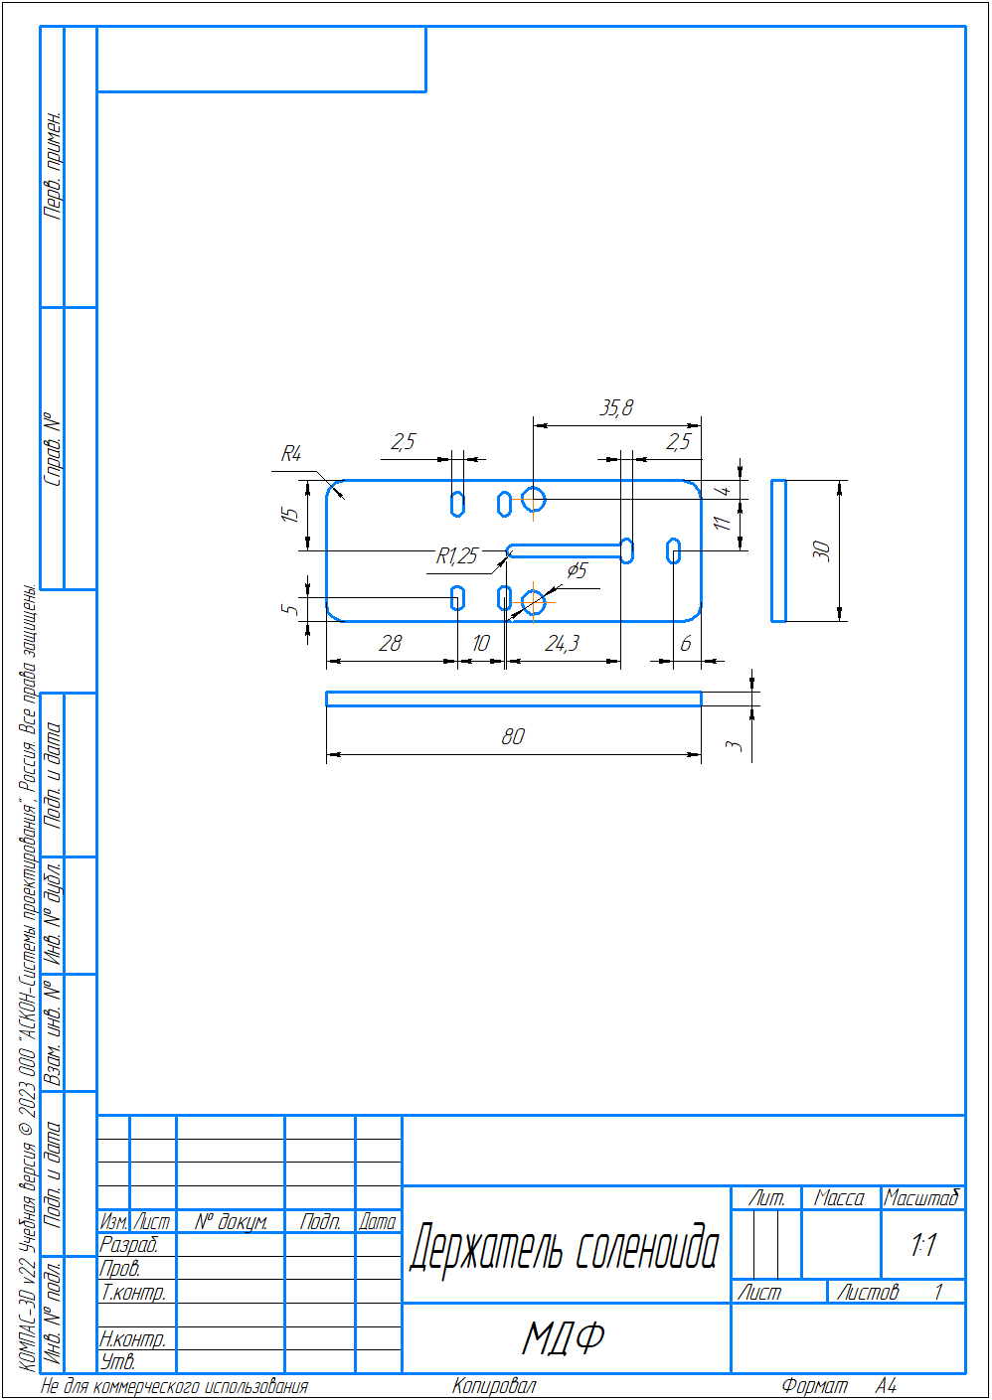
Чертежи/Держатель соленоида.png
