Deimos48/Braille_Public/Чертежи/Задняя стена.png

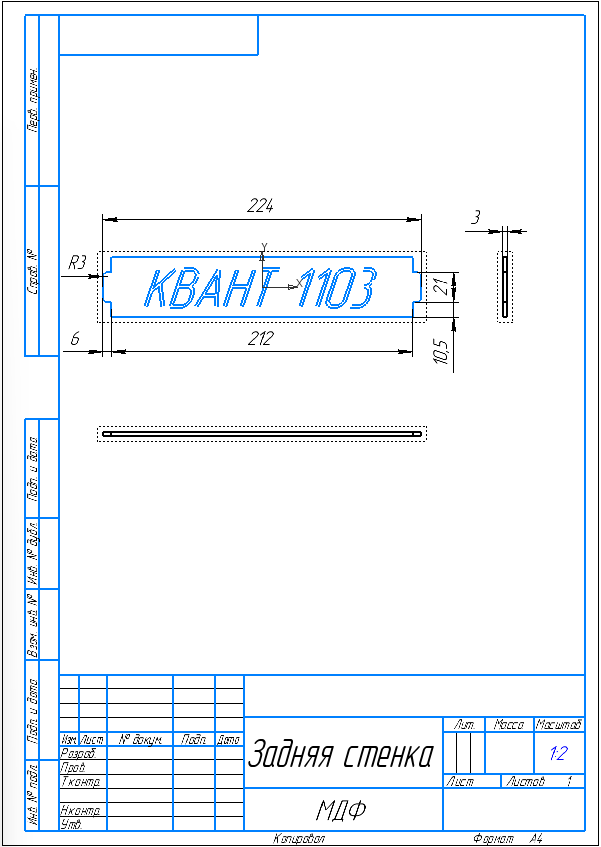
Чертежи/Задняя стена.png
