Deimos48/Braille_Public/Чертежи/Крышка.png

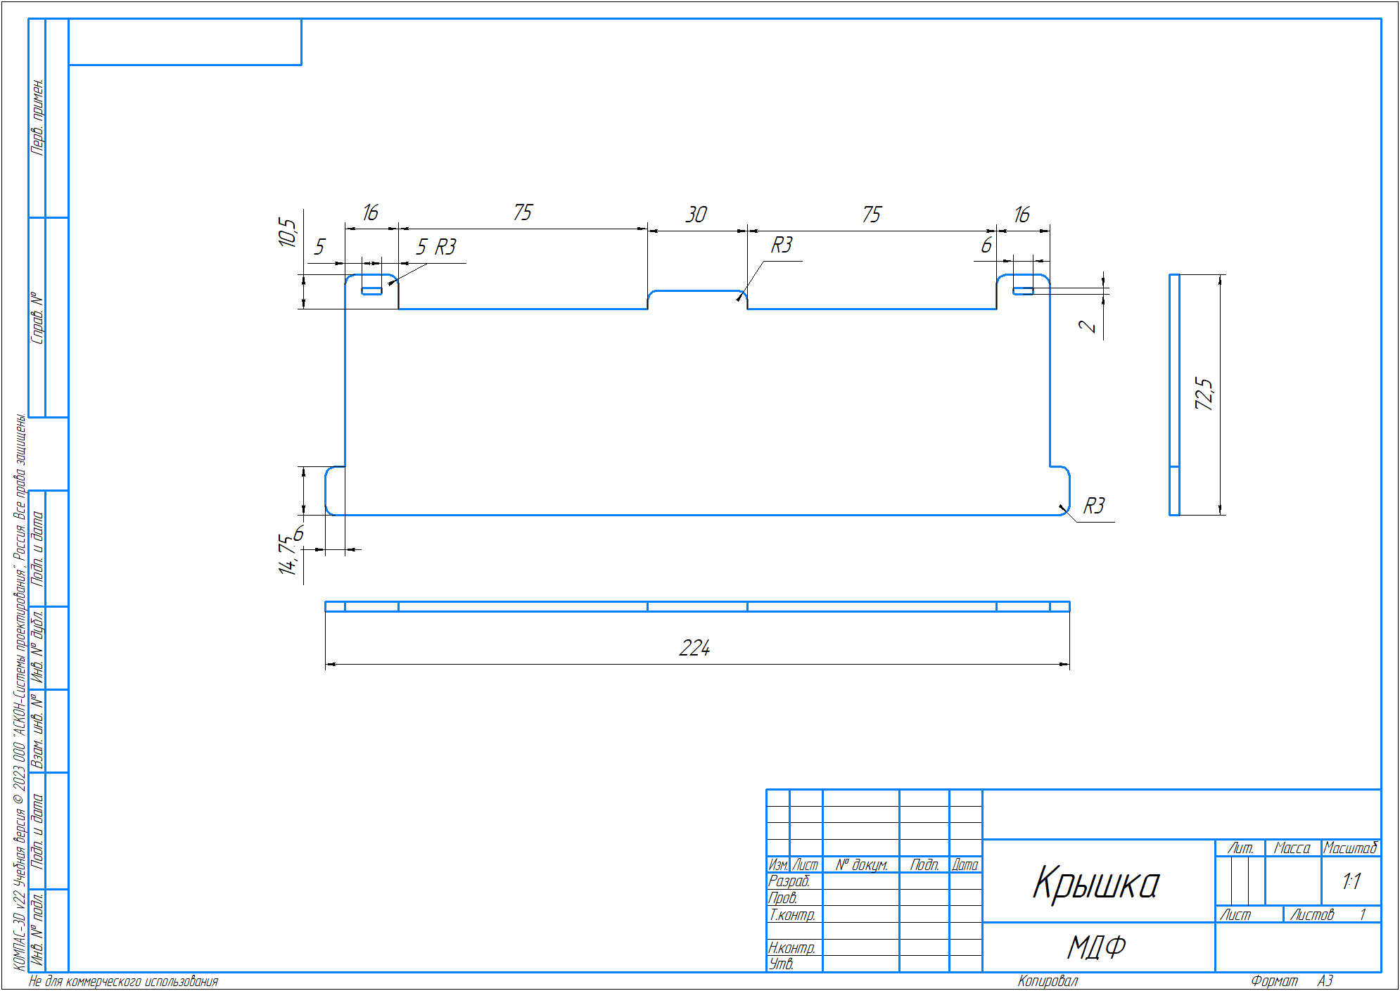
Чертежи/Крышка.png
