Deimos48/Braille_Public/Чертежи/Нижняя деталь.png

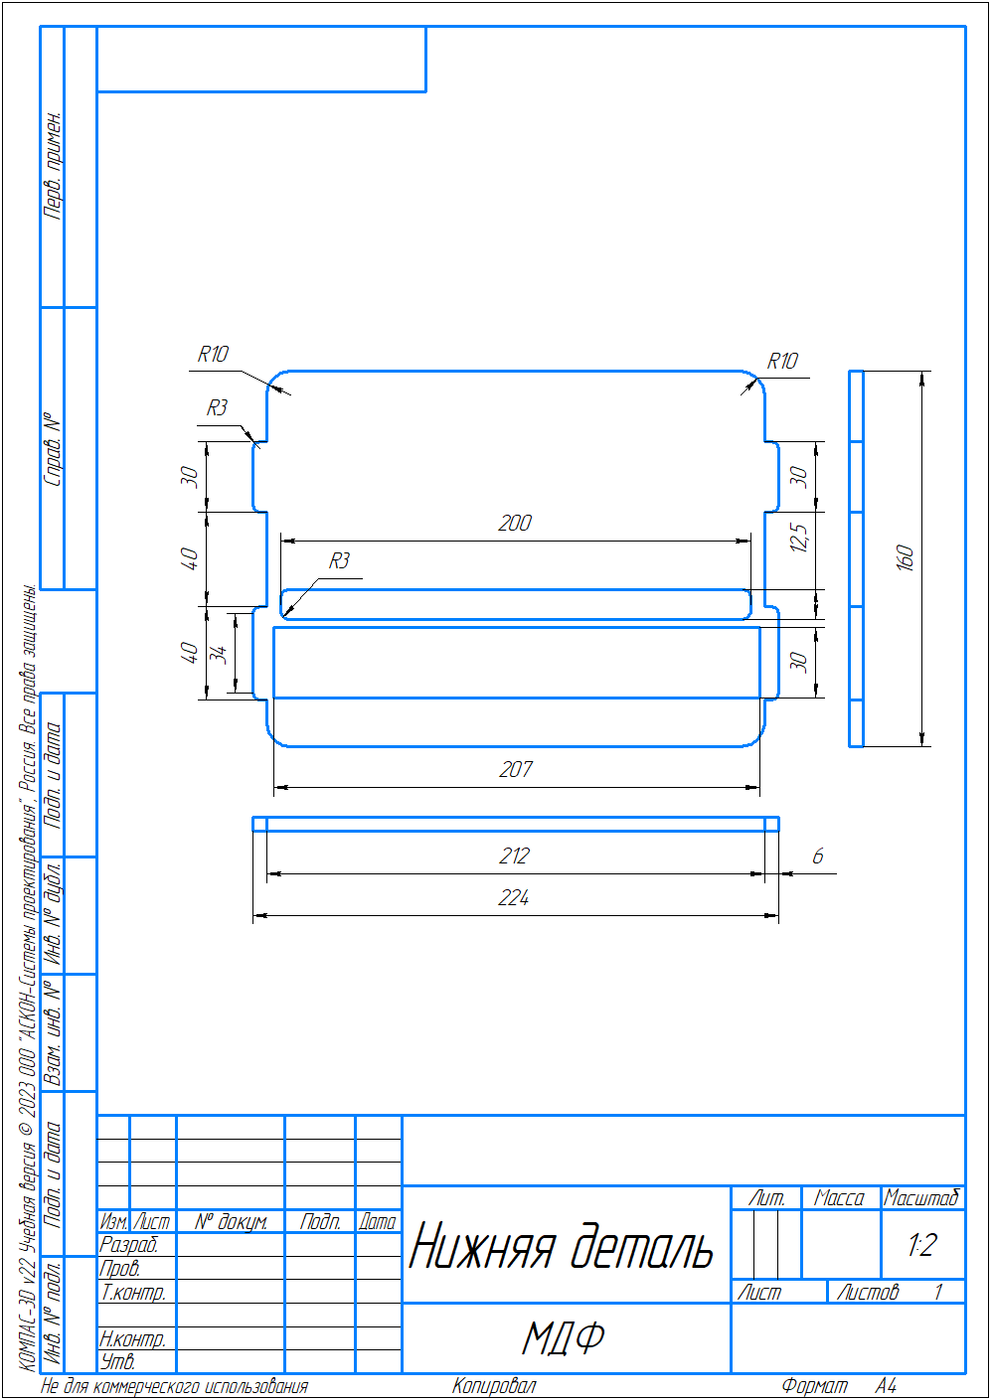
Чертежи/Нижняя деталь.png
