Deimos48/Braille_Public/Чертежи/Основание.png

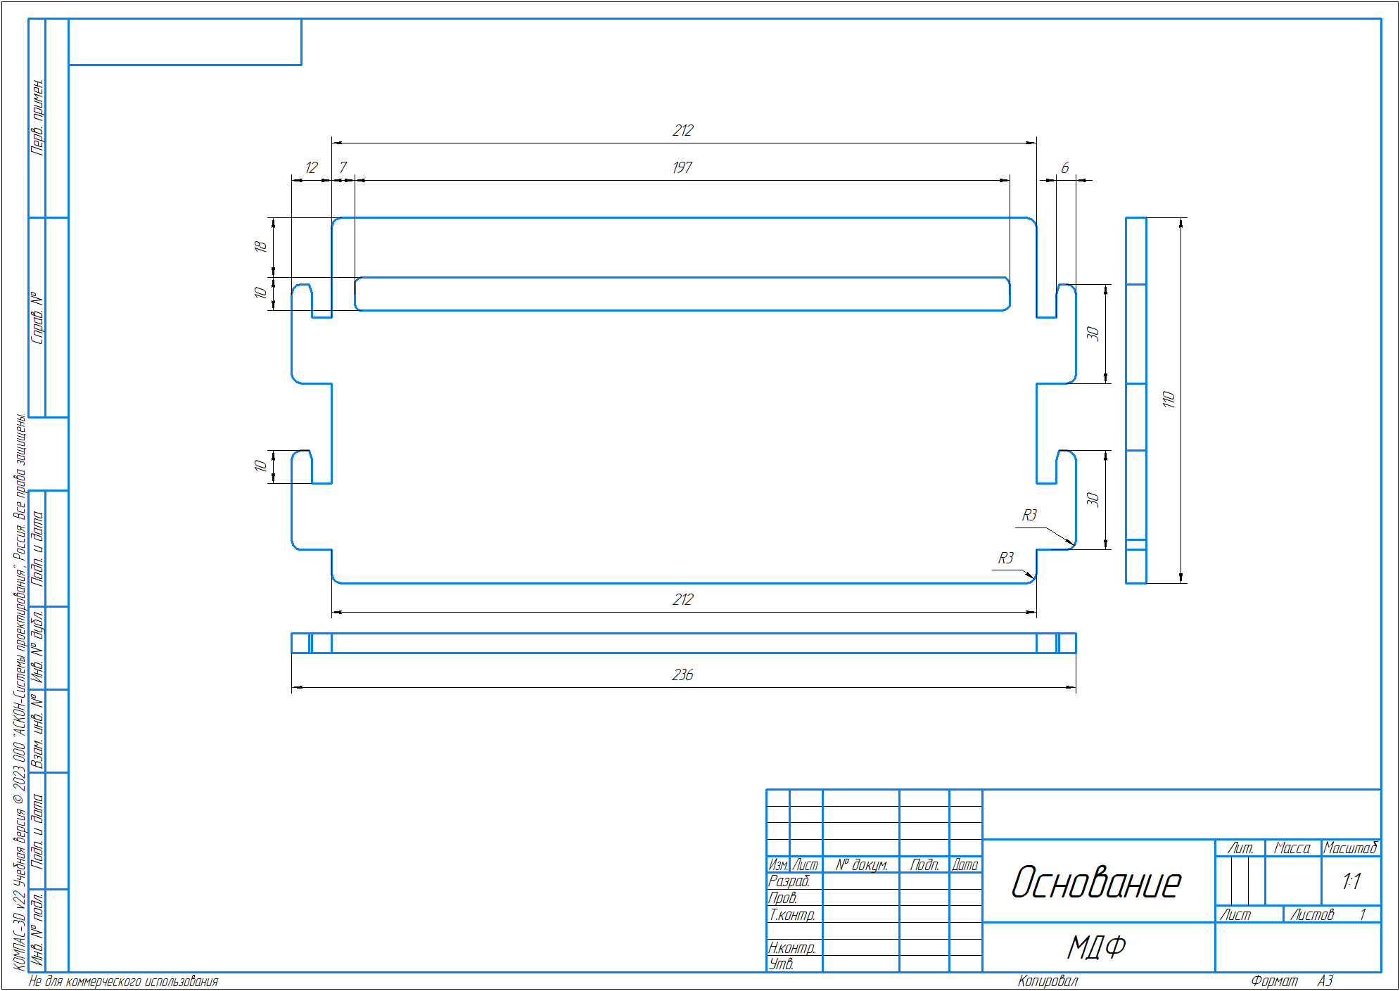
Чертежи/Основание.png
