Deimos48/Braille_Public/Чертежи/Подставка плат.png

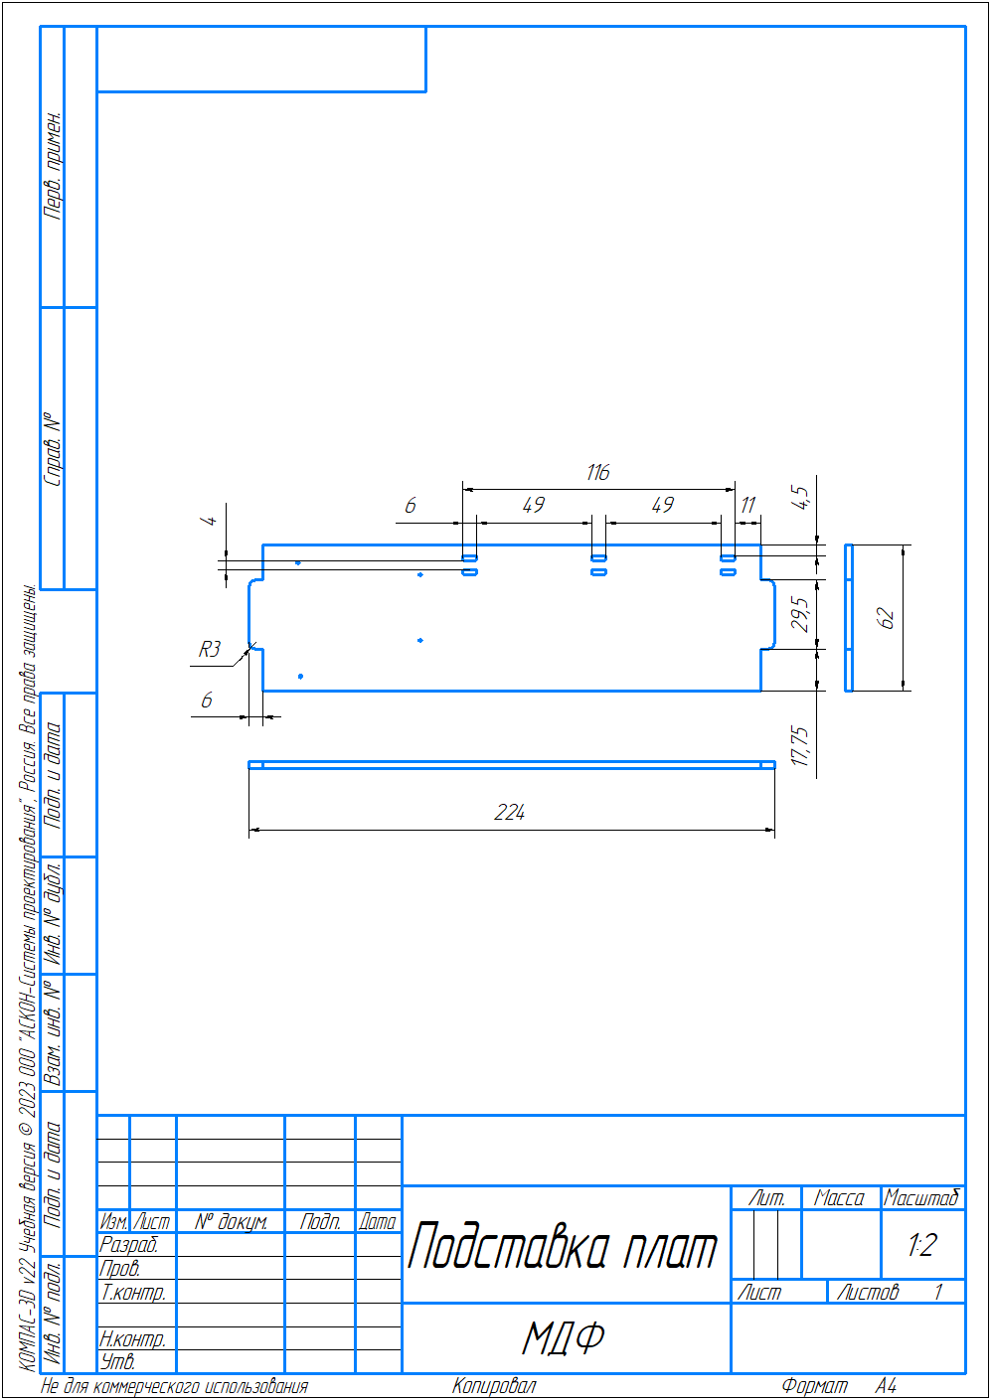
Чертежи/Подставка плат.png
