Deimos48/Braille_Public/Чертежи/Рейка печатной головки.png

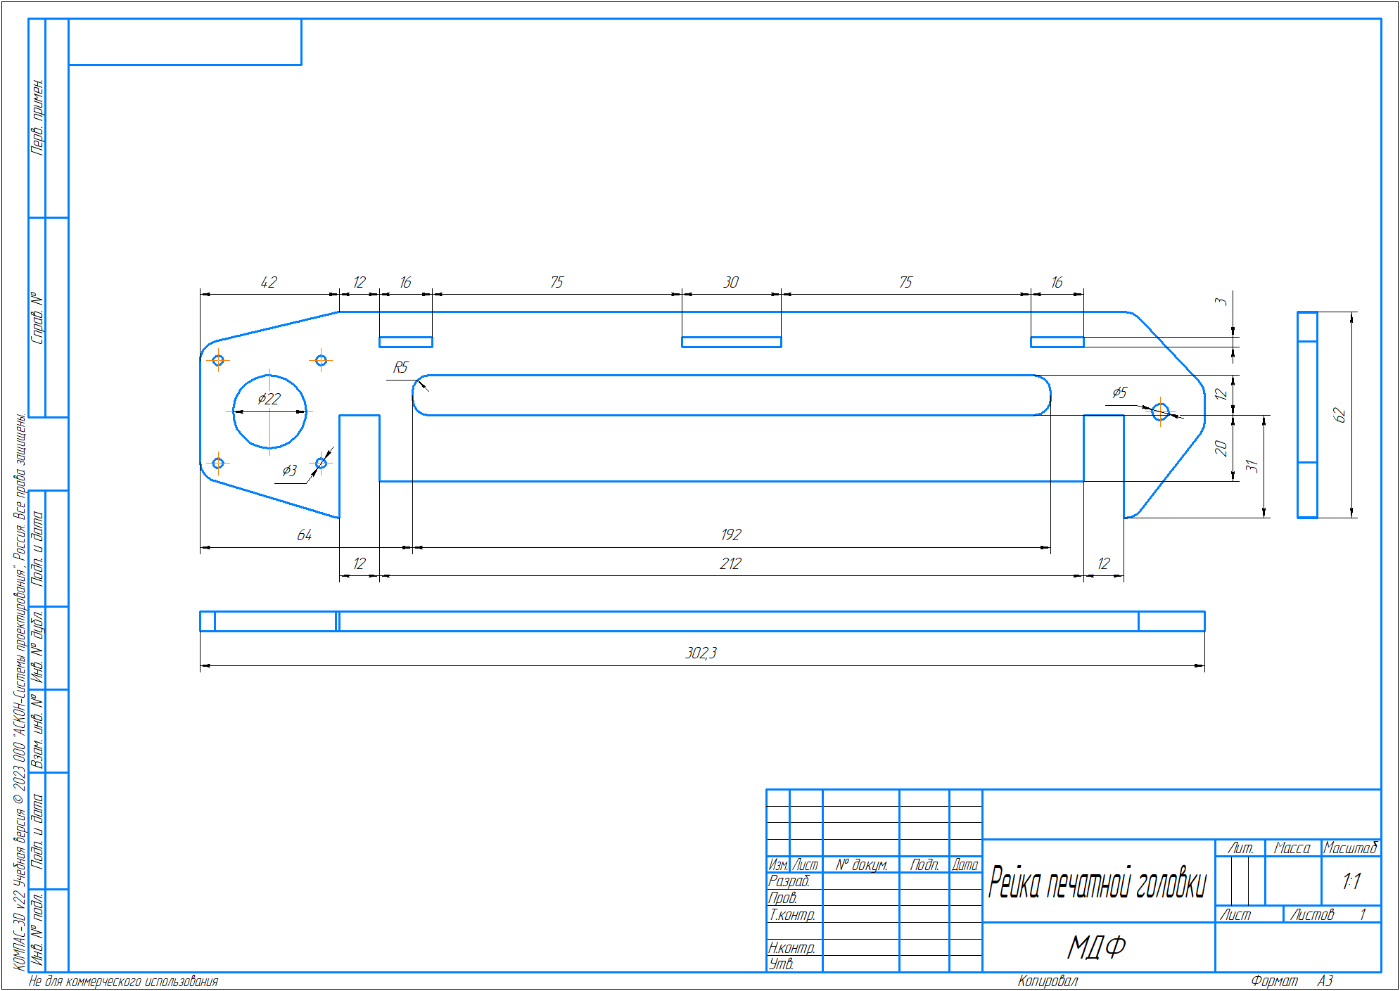
Чертежи/Рейка печатной головки.png
