Deimos48/Braille_Public/3D-модели/ЗадняяСтенка.stl

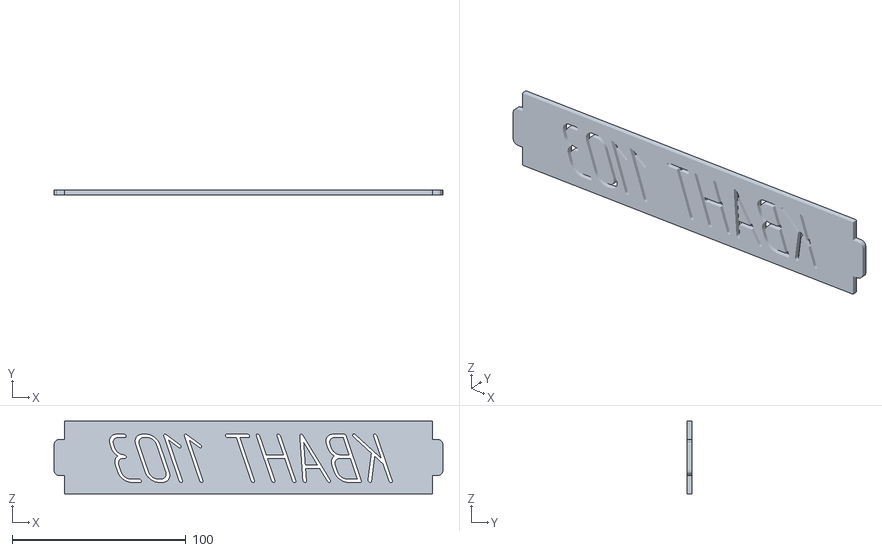
[picture p49: CAD file, 2024-02-12]
3D-модели/ЗадняяСтенка.stl
224.0 x 3.00 x 42.0
