Deimos48/Braille_Public/3D-модели/НижняяЧасть.stl

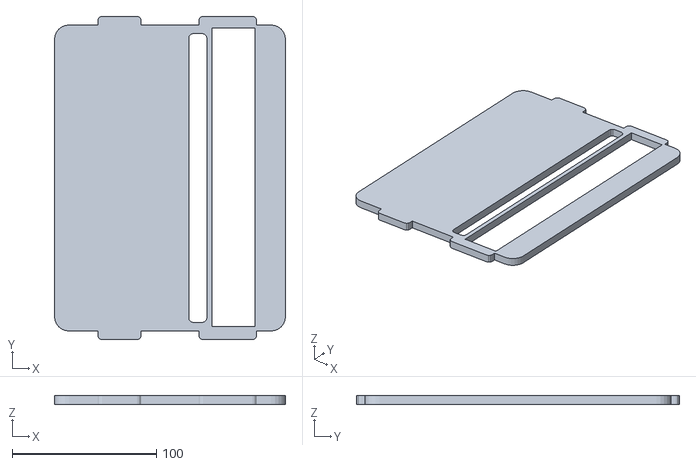
[picture p51: CAD file, 2024-02-12]
3D-модели/НижняяЧасть.stl
160.0 x 224.0 x 6.00
