Deimos48/Braille_Public/3D-модели/РейкаПечатнойГоловки.stl

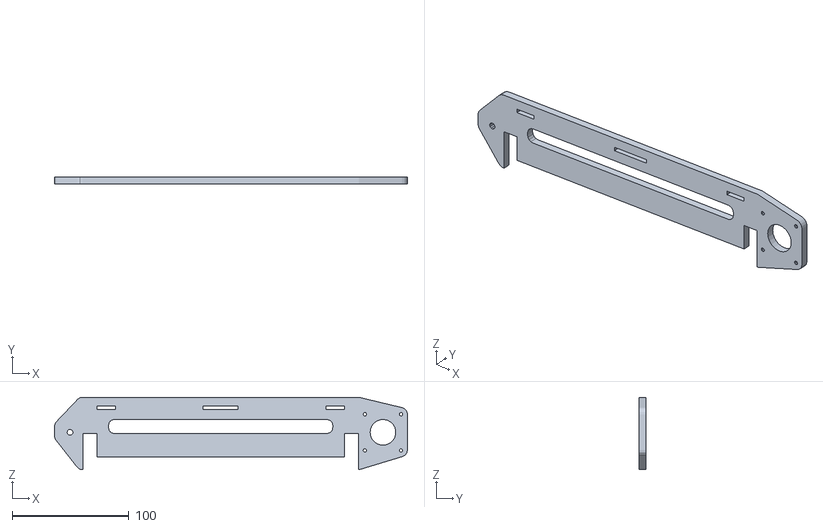
[picture p52: CAD file, 2024-02-12]
3D-модели/РейкаПечатнойГоловки.stl
302.3 x 6.00 x 62.0
