Deimos48/Braille_Public/3D-модели/БоковаяСтенка.stl

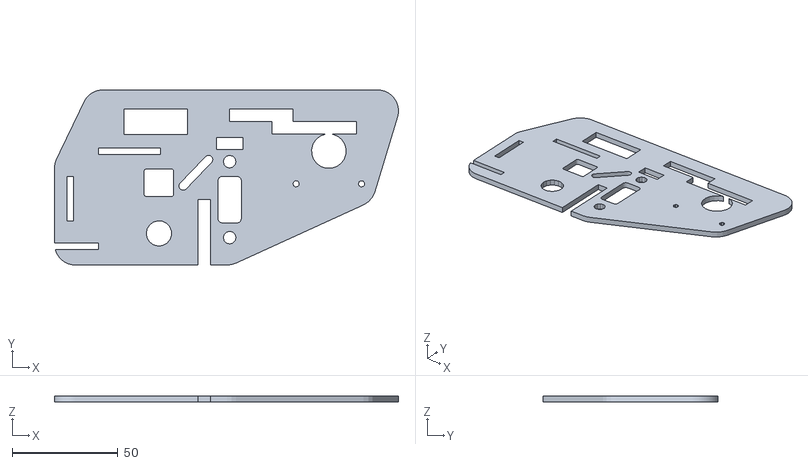
[picture p53: CAD file, 2024-02-12]
3D-модели/БоковаяСтенка.stl
163.0 x 83.0 x 3.00
