Deimos48/Braille_Public/3D-модели/ПодставкаПлат.stl

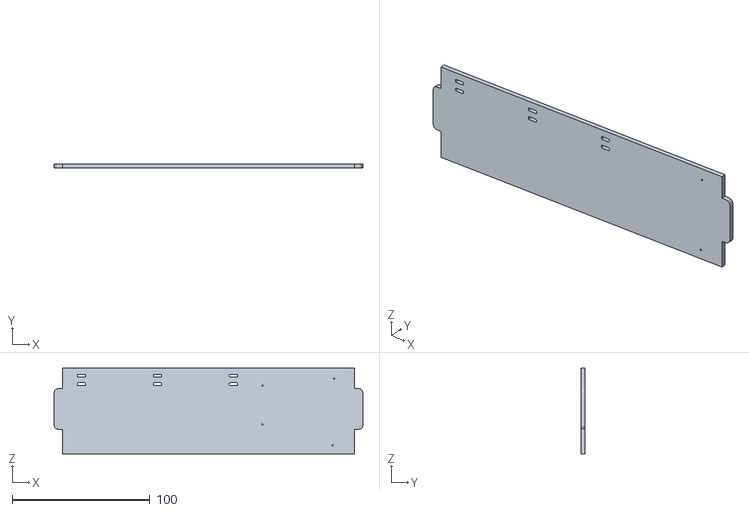
[picture p54: CAD file, 2024-02-12]
3D-модели/ПодставкаПлат.stl
224.0 x 3.00 x 62.0
