Deimos48/Braille_Public/3D-модели/Крышка.stl

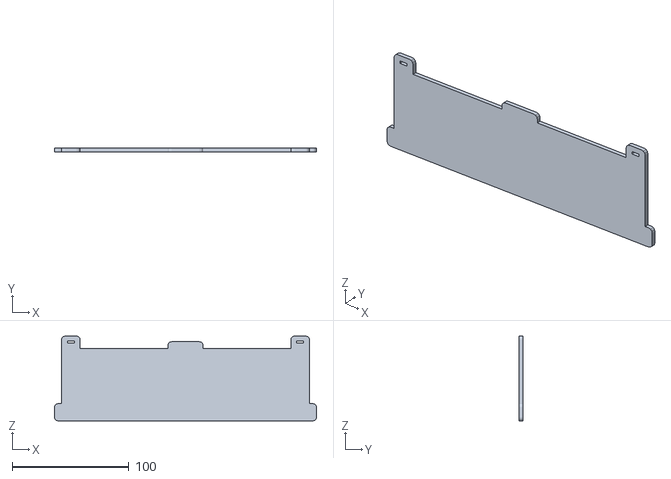
[picture p55: CAD file, 2024-02-12]
3D-модели/Крышка.stl
224.0 x 3.00 x 72.5
