Deimos48/Braille_Public/3D-модели/ДержательСоленоида.stl

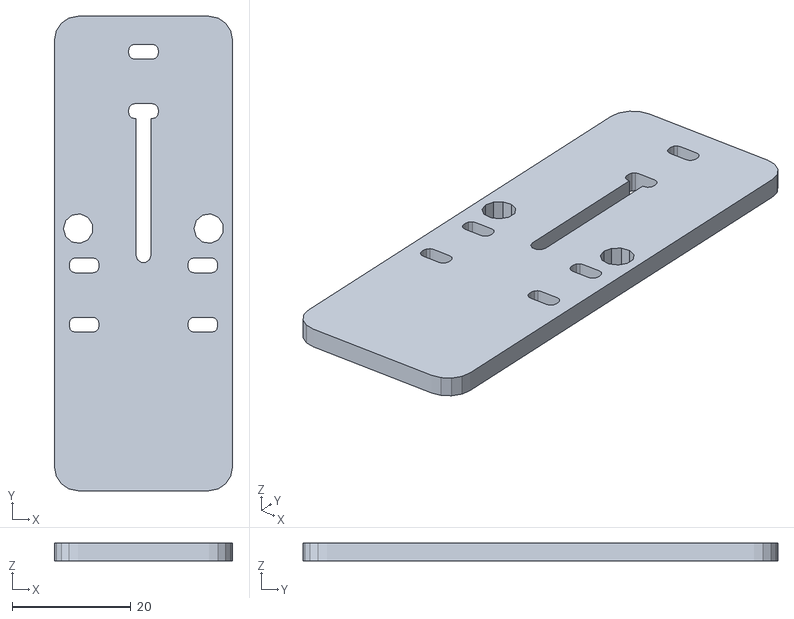
[picture p56: CAD file, 2024-02-12]
3D-модели/ДержательСоленоида.stl
30.0 x 80.0 x 3.00
