Deimos48/Braille_Public/3D-модели/Основание.stl

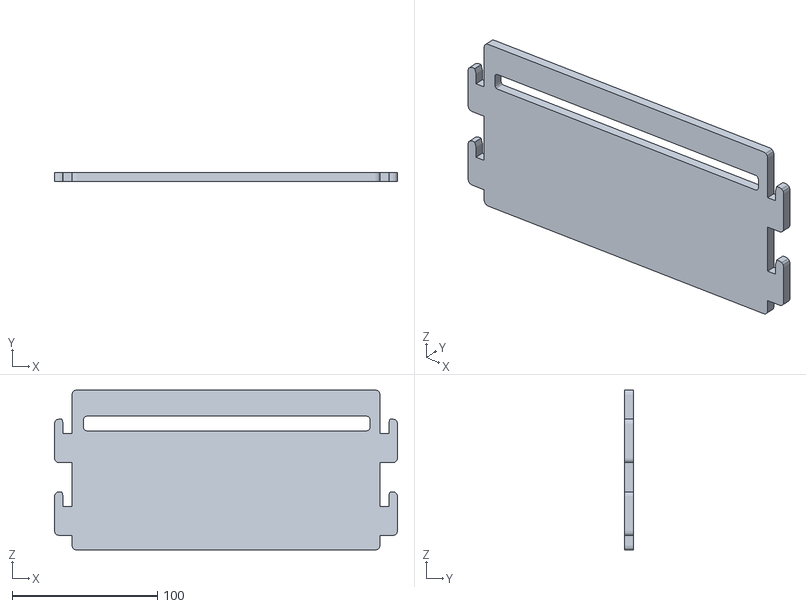
[picture p57: CAD file, 2024-02-12]
3D-модели/Основание.stl
236.0 x 6.00 x 110.0
