Deimos48/Braille_Public/3D-модели/БоковаяСтенка2.stl

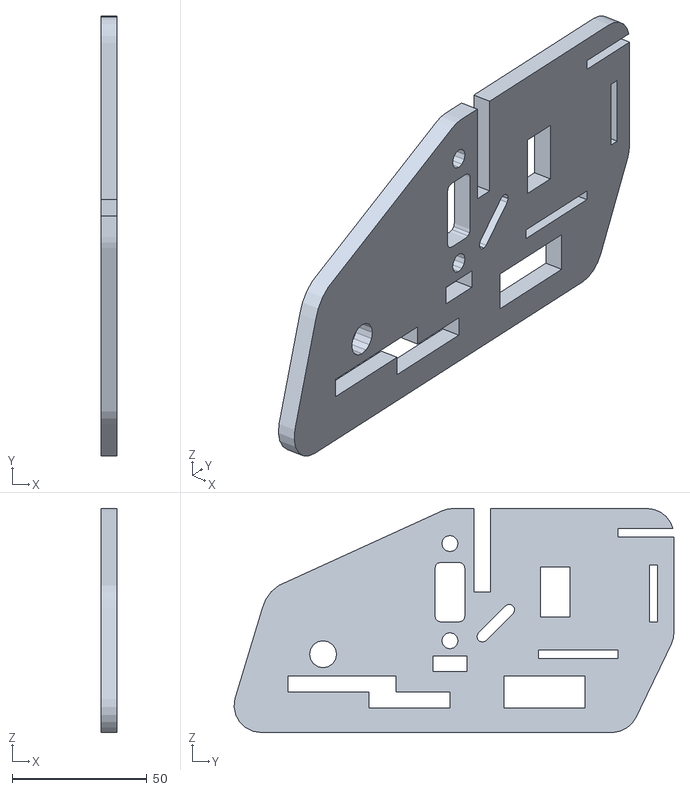
[picture p58: CAD file, 2024-02-12]
3D-модели/БоковаяСтенка2.stl
6.00 x 163.0 x 83.0
