Deimos48/Braille_Public/3D-модели/Брайль_детали 3мм.stl

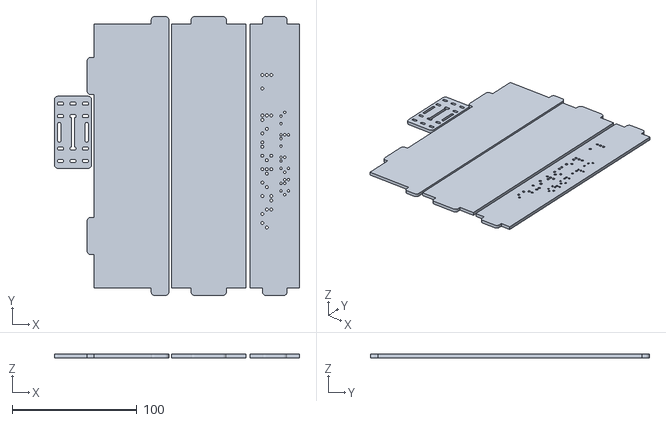
[picture p59: CAD file, 2024-02-09]
3D-модели/Брайль_детали 3мм.stl
197.0 x 224.0 x 3.00
