Deimos48/Braille_Public/3D-модели/Брайль_детали 6мм.stl

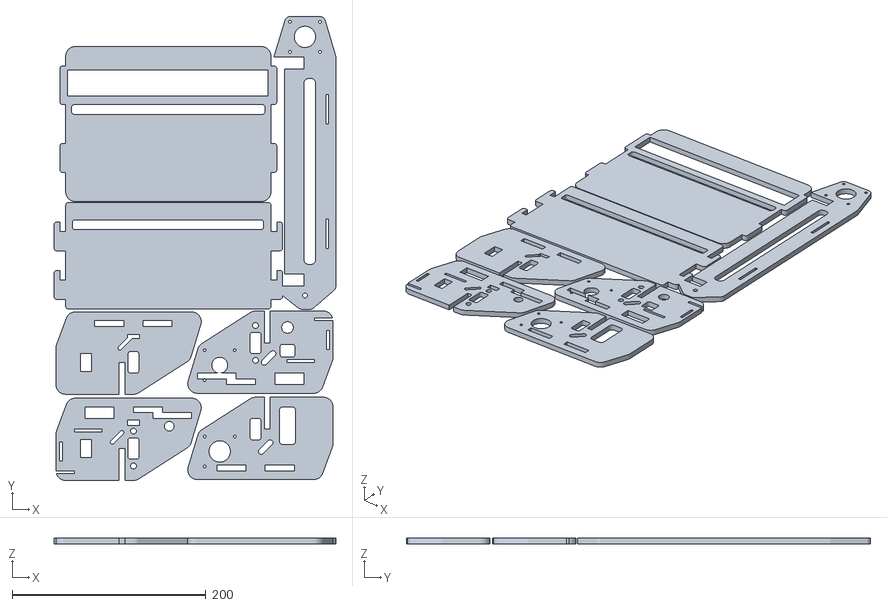
[picture p60: CAD file, 2024-02-09]
3D-модели/Брайль_детали 6мм.stl
291.0 x 479.0 x 6.00
