Deimos48/Braille_Public/(list of files, cad)

Other CAD files:
3D-модели/БоковаяСтенка3.stl
