Deimos48/Braille_Public/(commit log)

2024-02-09 Create folder Программный код
2024-02-09 Create folder 3D-модели
2024-02-09 Create foledr Видеоролик
2024-02-09 Create folder Фотографии разработанного устройства
2024-02-09 Create Тест
2024-02-12 Create Чертежи
    Чертежи всех деталей
2024-02-12 Delete Чертежи
    я случайно, простите пжпжпжпжпж
2024-02-12 Обновление
    Добавлены новые файлы, разделены между собой чертежи и скрины моделей
2024-02-12 Update тест
2024-02-12 models
    Добавлены модели .stl, подкорректированы названия некоторых моделей и чертежей
    [БоковаяСтенка.stl, БоковаяСтенка2.stl, БоковаяСтенка3.stl, БоковаяСтенка4.stl, Брайль_детали 3мм.stl, Брайль_детали 6мм.stl, ДержательСоленоида.stl, ЗадняяСтенка.stl]
2024-02-12 Добавлена документация
    [Брайль_детали 3мм.stl, Брайль_детали 6мм.stl, ЗадняяСтенка2.stl]
2024-02-12 Кодики
2024-02-12 Обновлённая документация
    Сделана в формате .pdf, в пункте 10 выставлены новые ссылки
2024-02-12 Delete ~$кументация для предпрофиля (1).docx
    Удалён лишний файл
2024-02-12 Delete ~WRL0005.tmp
    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
2024-02-12 Обновлена документация
2024-02-12 Добавление фото результата и ссылки на видео Rutube
2024-02-12 Обновлённая документация
    Обновлена документация, добавлена новая 3D модель
    [ЗадняяСтенка.stl, ЗадняяСтенка2.stl]
2024-02-12 Переименование фото устройства
2024-02-12 Rename Документация для предпрофиля (1).docx to Документация для предпрофиля.docx
    Изменено название
2024-02-12 Добавлен чертёж обновлённой детали
